alma-mesic/school-bell-system/desktop-app/SchoolBellSystem/4k-Abstract-Gradient-Wave-Digital-Art-Wallpaper.jpg

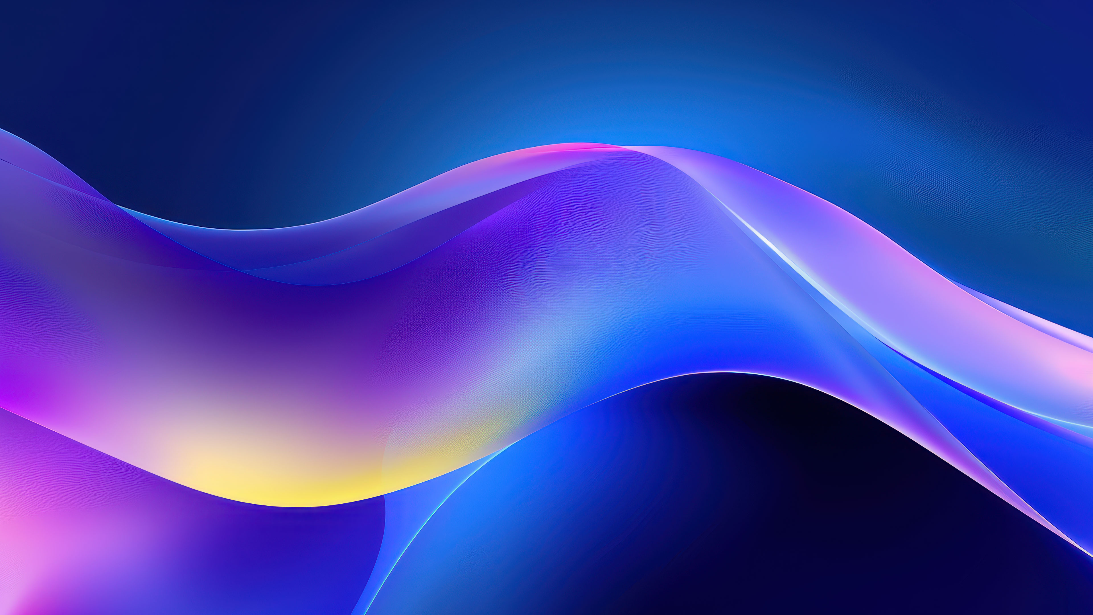
desktop-app/SchoolBellSystem/4k-Abstract-Gradient-Wave-Digital-Art-Wallpaper.jpg
