alma-mesic/school-bell-system/desktop-app/SchoolBellSystem/SchoolBellSystem/Resources/Untitled design1.png

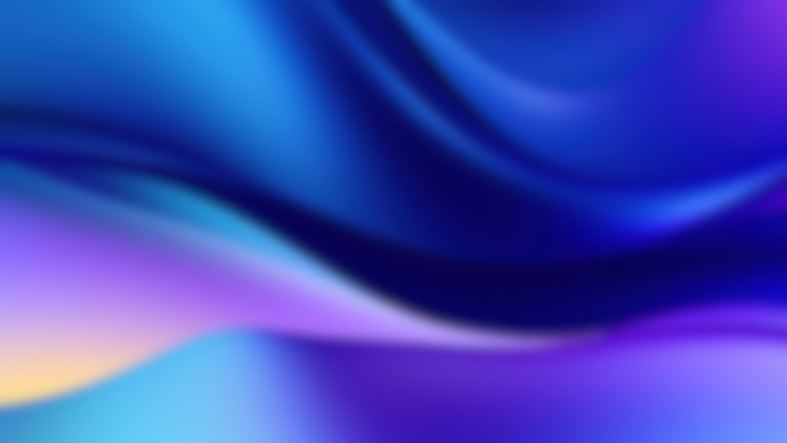
desktop-app/SchoolBellSystem/SchoolBellSystem/Resources/Untitled design1.png
