alma-mesic/school-bell-system/docs/tabela komponenti.docx

Naziv komponente | Izgled komponente | Kratak opis

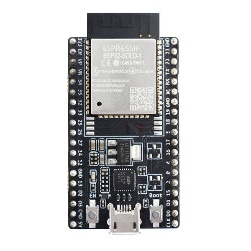
[picture p3: figure]
ESP32-DevKitC-S1 Espressif Systems | Mouser Hungary

- ESP32 mikrokontroler | | ESP32 mikrokontroler upravlja senzorima, prikazom i komunikacijom uređaja, omogućavajući automatsko prikupljanje i obradu podataka.

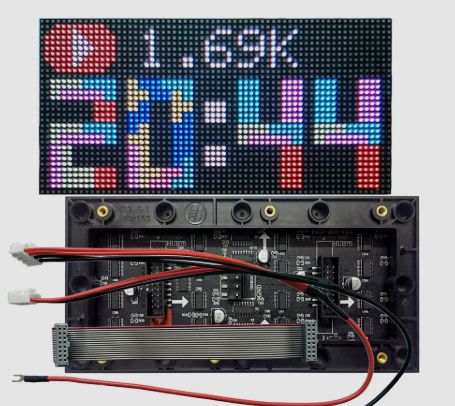
[picture p4: figure]

- LED Matrica HUB75 32x64 P4 (RGB) | | LED matrica HUB75 32x64 P4 (RGB) prikazuje slike, tekst i animacije u boji pomoću kontrolisanih RGB LED dioda, gdje P4 označava razmak između piksela od 4 mm.

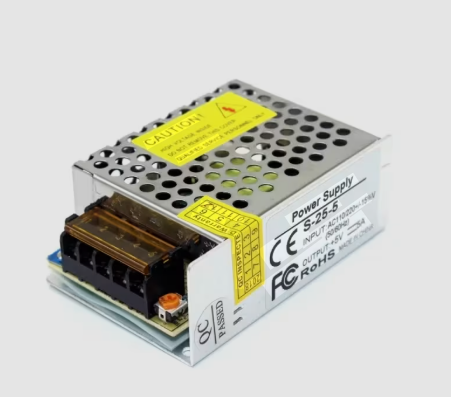
[picture p5: figure]

- Napojna jedinica (5V, 5A, 25W) | | Napojna jedinica (5V, 5A, 25W) služi za napajanje slova na ploči i daje dovoljan napon matrici.

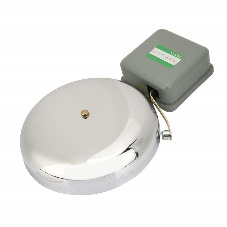
[picture p6: figure]
School Ring Time Bell 8 inch Stainless Steel Electric Bell Ring Factory Agencies School Home Use 220V 35W : Amazon.com.au: Home Improvement

- Školsko zvono | | Školsko zvono omogućava zvonjavu u predivđeno vrijeme i njime se operiše uz pomoć releja koji zatvara i otvara kontakt propuštajući signal.

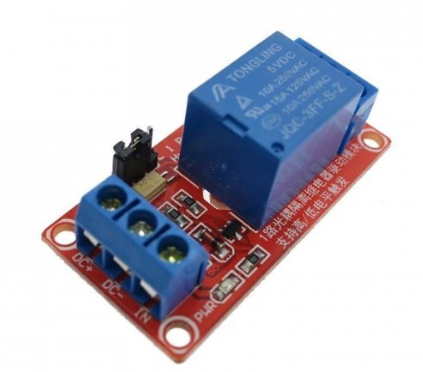
[picture p7: figure]

- Relej | | Relej modul omogućava ESP32 mikrokontroleru da upravlja fizičkim školskim zvonom uključivanjem i isključivanjem strujnog kola.

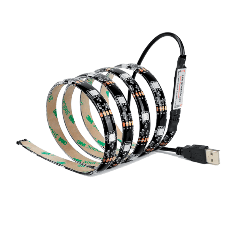
[picture p8: figure]
USB LED TRAKA 5050 5VDC 30PCS/M IP20 RGB 3m | ELMARK

- RGB LED traka | | RGB LED traka pruža osvjetljenje u više nijansi boja zbog prisustva crvenih, zelenih i plavih dijoda. Korisna je za ljepši vizuelni prikaz i radi estetike.

Tabela 1.1. najvažnije korištene komponente

Napomena:

U datoj tabeli su prikazane najvažnije komponente korištene za izradu ovog maturskog rada. Ukupni opis svih komponenata nalazi se u poglavlju 4. (Hardversko rješenje za School Bell System s LED reklamom).

Izrada ovog maturskog rada zasniva se na povezivanju nekoliko ključnih dijelova koji zajedno omogućavaju da cijeli sistem radi precizno i bez zastoja. Glavna komponenta je ESP32 mikrokontroler, koji možemo opisati kao mozak uređaja. Njegov zadatak je da prikuplja podatke, obrađuje ih i šalje naredbe ostalim dijelovima kako bi cijeli proces bio potpuno automatizovan. Za prikazivanje informacija, tačnog vremena i različitih animacija, korištena je LED matrica HUB75. Zahvaljujući gustom rasporedu RGB dioda, tekst i prikaz su jasni i lako čitljivi čak i sa veće udaljenosti.

Kako bi sve ove komponente funkcionisale stabilno, ugrađena je napojna jedinica od 5V. Ona je veoma bitna jer osigurava stalan napon, čime se izbjegava treperenje matrice ili problemi u radu mikrokontrolera kada je potrošnja energije najveća.

Poseban dio projekta čini sistem za upravljanje školskim zvonom. Budući da mikrokontroler radi na niskom naponu i ne može direktno pokretati jače električne uređaje, u sklop je ubačen relej. On služi kao elektronski prekidač koji, po signalu sa ESP32, zatvara strujni krug i aktivira zvono u tačno predviđeno vrijeme.

Na samom kraju, ugrađena je i RGB LED traka koja upotpunjuje vizuelni izgled uređaja. Ona pruža ambijentalno osvjetljenje, a zbog kombinacije osnovnih boja, omogućava prilagođavanje izgleda samog kućišta. Sve ove komponente zajedno čine jednu cjelinu koja uspješno povezuje funkciju digitalnog informativnog panela i sistema za automatsko aktiviranje školskog zvona.

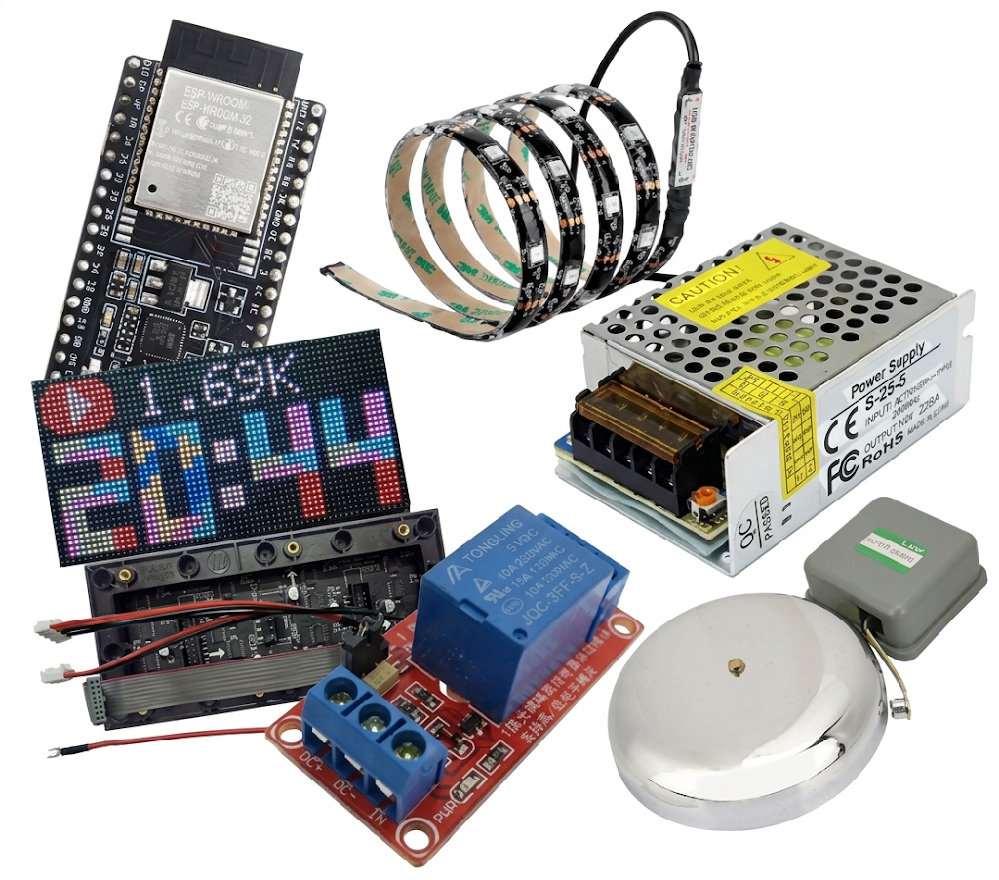
[picture p9: figure]

Slika 2.1. najvažnije korištene komponente
