alma-mesic/school-bell-system/docs/Maturski rad - urnek (1).docx

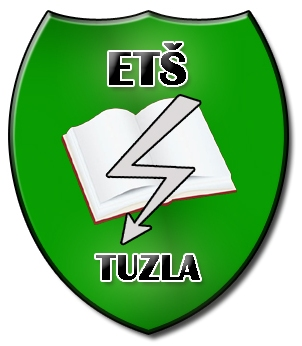
[picture p10: figure]
Description: Description: zelena2

JU MJEŠOVITA SREDNJA ELEKTROTEHNIČKA ŠKOLSKA GODINA

ŠKOLA TUZLA 2025./2026.

MATURSKI RAD

Predmet: Digitalna tehnika

Tema: School Bell System

MENTOR: UČENIK:

Zulfić Edin, dipl. ing. el.teh. Alma Mešić

Mandžukić Asmir, dipl. ing. el. teh Lamija Mujkić

TUZLA, maj, 2026.god.

# 1. Uvod

Četiri godine pohađamo ovu školu i dobro poznajemo njene hodnike, učionice i dnevni ritam nastave. Ipak, čak i uz toliko iskustva, određena obavještenja i rasporedi skraćene nastave često ostaju nepoznanica do posljednje minute. Često se dešava da učenici ili posjetioci škole ne znaju gdje se trebaju nalaziti, posebno u situacijama kada se u hodnicima istovremeno nalazi veliki broj ljudi. Tokom međusmjena, kada se približno pedeset učenika kreće hodnicima u isto vrijeme, lako može doći do konfuzije, a pravovremeno informisanje postaje gotovo nemoguće.

Problem je naročito vidljiv kod posjetilaca, gostujućih predavača ili novih učenika, koji nemaju iskustvo kretanja unutar škole. Oni se često suočavaju s nejasnim rasporedom i moraju se oslanjati na druge učenike ili nastavno osoblje kako bi saznali gdje trebaju biti. Slično važi i za situacije kada nastavnici moraju pratiti promjene rasporeda ili posebno obavještenja, kao što su promjene termina nastave, testiranja ili vanredna obavještenja. U takvim okolnostima ručno praćenje rasporeda i obavještenja može biti zamorno, nepraktično i sklono greškama.

Zbog ovih izazova, ideja projekta „School Bell System“ proizašla je iz stvarne potrebe da se upravljanje školskim rasporedom i obavještenjima pojednostavi i učini dostupnim u realnom vremenu. Sistem je zamišljen tako da učenicima, nastavnicima i posjetiocima pruži jednostavan, pregledan i pouzdan način praćenja svih relevantnih informacija. Ideja nije samo da se automatizuje zvono, već i da se omogući pravovremeno obavještavanje o događanjima unutar škole, uključujući raspored skraćene nastave, testove, posebne obavijesti i hitne situacije.

Primarna svrha sistema je stvoriti okruženje u kojem svi korisnici – bilo da su učenici, nastavnici ili posjetioci – imaju pristup ažurnim informacijama bez potrebe za dodatnim pitanjima, provjerama ili čekanjem. Time se ne samo smanjuje konfuzija i stres u hodnicima, već se i poboljšava efikasnost svakodnevnog školskog života. Učenici mogu planirati svoje vrijeme između časova, a nastavno osoblje može lakše organizovati aktivnosti i pratiti promjene u rasporedu.

Ovaj projekat takođe demonstrira kako primjena jednostavnih, ali praktičnih tehnologija može značajno unaprijediti svakodnevne procese u školskom okruženju. Ideja je da sistem bude intuitivan i jednostavan za korištenje, tako da njegova primjena ne zahtijeva dodatnu obuku niti tehničko predznanje korisnika. Cilj je omogućiti da informacije budu dostupne svima u realnom vremenu, a da pritom cijeli proces bude automatizovan i pouzdan.

Kombinacija ovih funkcionalnosti – automatsko zvono, prikaz obavještenja i upravljanje rasporedom – predstavlja kompletno rješenje za jednu od svakodnevnih, ali značajnih problema unutar škole. Uvođenjem ovog sistema, škola dobija način da na moderan i efikasan način informiše sve korisnike i smanji potrebu za manuelnom kontrolom. To omogućava bolju organizaciju i poboljšava ukupno iskustvo učenika i osoblja u školskom okruženju, čineći svakodnevne aktivnosti jasnijim i preglednijim.

# 2. Korištene komponente i tehnička osnova

Naziv komponente | Izgled komponente | Kratak opis

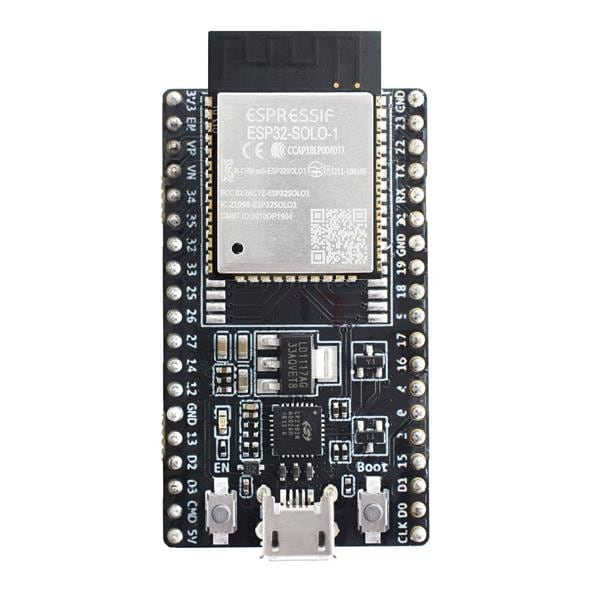
[picture p11: figure]
ESP32-DevKitC-S1 Espressif Systems | Mouser Hungary

- ESP32 mikrokontroler | | ESP32 mikrokontroler upravlja senzorima, prikazom i komunikacijom uređaja, omogućavajući automatsko prikupljanje i obradu podataka.


- LED Matrica HUB75 32x64 P4 (RGB) | | LED matrica HUB75 32x64 P4 (RGB) prikazuje slike, tekst i animacije u boji pomoću kontrolisanih RGB LED dioda, gdje P4 označava razmak između piksela od 4 mm.


- Napojna jedinica (5V, 5A, 25W) | | Napojna jedinica (5V, 5A, 25W) služi za napajanje slova na ploči i daje dovoljan napon matrici.

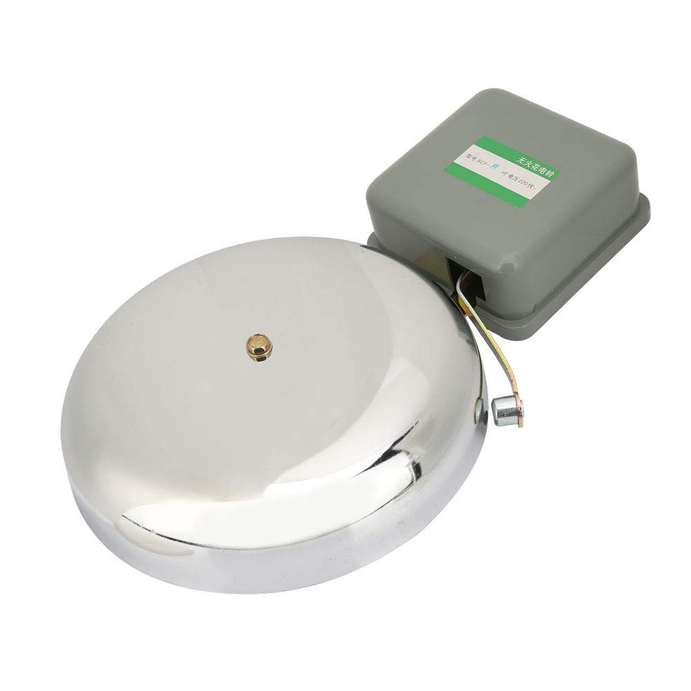
[picture p12: figure]
School Ring Time Bell 8 inch Stainless Steel Electric Bell Ring Factory Agencies School Home Use 220V 35W : Amazon.com.au: Home Improvement

- Školsko zvono | | Školsko zvono omogućava zvonjavu u predivđeno vrijeme i njime se operiše uz pomoć releja koji zatvara i otvara kontakt propuštajući signal.


- Relej | | Relej modul omogućava ESP32 mikrokontroleru da upravlja fizičkim školskim zvonom uključivanjem i isključivanjem strujnog kola.

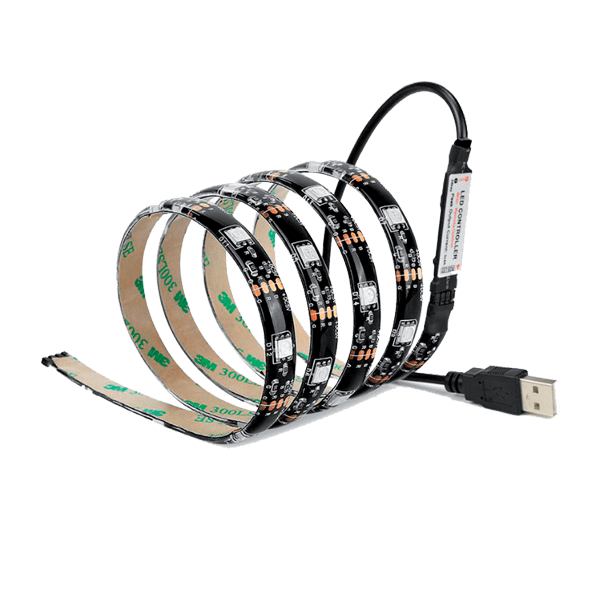
[picture p13: figure]
USB LED TRAKA 5050 5VDC 30PCS/M IP20 RGB 3m | ELMARK

- RGB LED traka | | RGB LED traka pruža osvjetljenje u više nijansi boja zbog prisustva crvenih, zelenih i plavih dijoda. Korisna je za ljepši vizuelni prikaz i radi estetike.

## 2.1. Esp32 mikrokontroler

ESP32-WROOM-32D je WiFi i Bluetooth dvojezgreni bežični komunikacijski modul koji je lansirala kompanija Espressif Systems. Ima dvojezgreni 32-bitni MCU koji integriše WiFi HT40 i Bluetooth/BLE 4.2 tehnologiju.

ESP32 čip (ESP wroom 32) integriše bogatstvo hardverskih perifernih uređaja, uključujući kapacitivne senzore dodira , Hall senzore , pojačala senzora sa niskim šumom, interfejse za SD kartice , Ethernet interfejse, brze SDIO/SPI, UART, I2S i I2C, itd.

ESP32 periferijski uređaji uključuju:

- 18 kanala analogno-digitalnog pretvarača (ADC)
- 3 SPI interfejsa
- 3 UART interfejsa
- 2 I2C interfejsa
- 16 PWM izlaznih kanala
- 2 digitalno-analogna pretvarača (DAC)
- 2 I2S interfejsa
- 10 kapacitivnih GPIO-a za očitavanje

Funkcije ADC-a (analogno-digitalnog pretvarača) i DAC-a (digitalno-analognog pretvarača) dodijeljene su određenim statičkim pinovima. Međutim, može se odlučiti koji su pinovi UART, I2C, SPI, PWM itd. - samo ih treba dodijeliti u kodu. To je moguće zahvaljujući funkciji multipleksiranja ESP32 čipa.

Iako svojstva pinova možemo definirati u softveru, postoje pinovi koji su dodijeljeni po zadanim postavkama kao što je prikazano na slici 2.1.1.

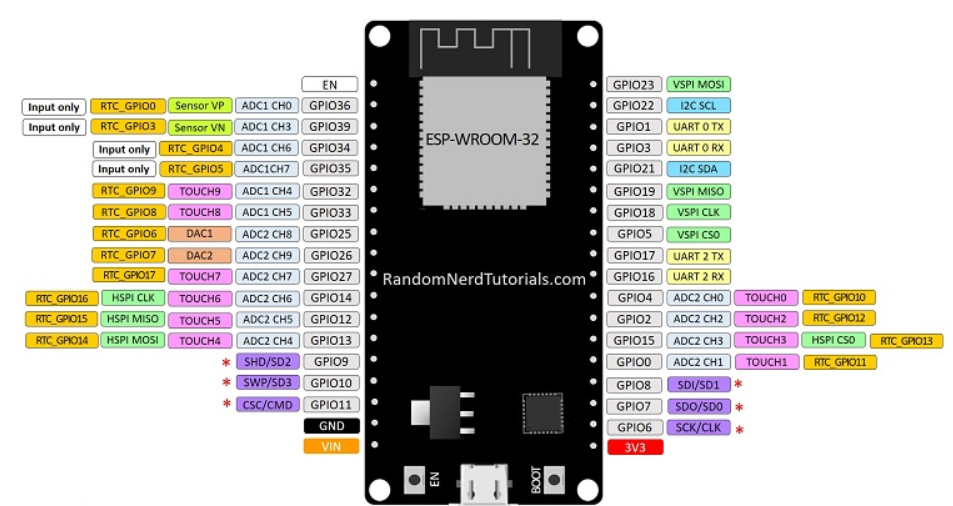
[picture p14: figure]

Slika 2.1.1.. ESP32 pinout

Ovi periferni uređaji i fleksibilna raspodjela pinova omogućavaju ESP32 mikrokontroleru da upravlja različitim komponentama i uređajima prema potrebama projekta.

Zahvaljujući kombinaciji visoke procesorske snage, energetske efikasnosti i ugrađenih komunikacijskih modula, ESP32 omogućava izradu kompleksnih i interaktivnih sistema koji mogu pratiti i reagovati na promjene u realnom vremenu, čime se značajno proširuju mogućnosti primjene u raznim pametnim i automatizovanim uređajima.

## 2.2. LED Matrica HUB75 32x64 P4 (RGB)

LED matrica HUB75 32x64 P4 (RGB) je panel sastavljen od 32x64 adresabilnih RGB LED dioda koje omogućavaju prikaz tekstova, slika i animacija u boji. Razmak između piksela od 4 mm (P4) pruža dobru preglednost na srednjim udaljenostima, dok istovremeno omogućava visoku gustinu prikaza.

Odlikuju je karakteristike od 2048 pojedinačne RGB LED diode, ekran u punom koloru, te podesiva svjetla. Dimenzija jedne matrice je 256cm x 128cm, a na ploči su dva HUB75 priključka, jedan za ulaz podataka kontrolera, jedan za izlaz i podrška za lanac. Ovaj tip matrice pruža online resurse i tutorijale za razvoj otvorenog koda, za upotrebu s Raspberry Pi, Arduinom i tako dalje.

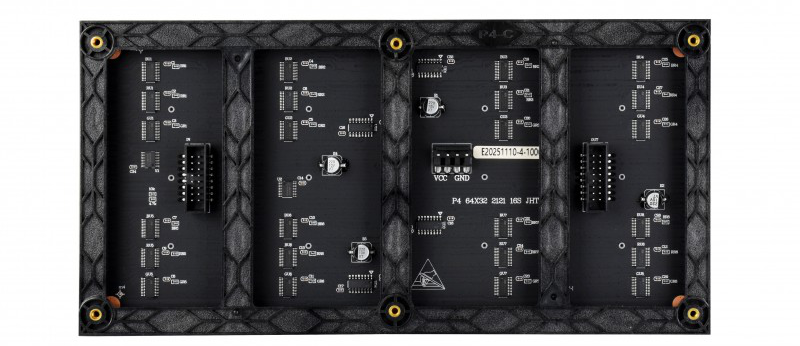
[picture p15: figure]
RGB Full-Color LED Matrix Panel, 4mm Pitch, 64×32 Pixels, Adjustable Brightness | RGB-Matrix-P4-64x32

Slika 2.2.1. pozadina LED 64x32 matrice

PIN | OPIS | | PIN | OPIS
VCC | Ulazno napajanje od 5V | | GND | Uzemljenje
R1 | Podaci višeg bita R | | R2 | Podaci nižeg bita R
G1 | Podaci višeg bita G | | G2 | Podaci nižeg bita G
B1 | Podaci višeg bita B | | B2 | Podaci nižeg bita B
A | Odabir A linije | | B | Odabir B linije
C | Odabir C linije | | D | Odabir D linije
E | Izbor E linije | | CLK | ulaz takta
LAT/STB | latch pin | | OE | output enable

Tabela 2.2.1. raspored pinova LED matrice

Tehnički detalji

- Dimenzije: 255 mm x 127 mm x 15 mm / 10,0” x 5,0” x 0,6”
- Težina panela sa IDC kablovima i kablovima za napajanje: 252,8 g
- Kompatibilan s M3 vijcima za montažu
- Regulisani ulaz napajanja od 5V, ~4A maks. (sve LED diode uključene)
- Brzina skeniranja 1/16
- Unutrašnji ekran, vidljivost od 160 stepeni
- Ekrani se mogu lančano/serijski povezivati - povezivanjem jednog izlaza sa sljedećim ulazom

## 2.3. Napojna jedinica

Napojna jedinica je ključna komponenta svakog elektronskog sistema, jer obezbjeđuje stabilan i pouzdan izvor energije za sve uređaje i module. Njena osnovna funkcija je da pretvara električnu energiju iz izvora napajanja, poput mreže ili baterije, u napone i struje prilagođene potrebama povezane elektronike.

Osim toga, napojna jedinica štiti uređaje od prenapona i kratkog spoja u napajanju, čime se smanjuje rizik od oštećenja i prekida u radu sistema.

Princip rada napojne jedinice zasniva se na pretvaranju i regulaciji električne energije. Ulazna struja se kroz transformator, ispravljač i filtere pretvara u jednosmernu struju odgovarajuće snage, dok regulator napona održava konstantan izlazni napon bez obzira na promjene u opterećenju ili ulaznoj struji.

Za naš projekat koristimo napojnu jedinicu od 5 V i 5 A, koja je dovoljna da napaja LED matricu i RGB trake na slovima. Ovaj izbor omogućava sigurno i stabilno napajanje svih LED dioda, bez fluktuacija napona ili prenapona, čime se osigurava pravilno i ujednačeno osvjetljenje i pouzdan rad sistema.

# 3. Korištene tehnologije

U izradi ovog maturskog rada korišten je niz tehnologija i razvojnih okruženja koja su omogućila realizaciju funkcionalnosti sistema. Ključnu ulogu u razvoju imali su programski jezici C++ i C#, koji su korišteni za implementaciju logike mikrokontrolerskog sistema i desktop aplikacije. Pored njih, značajnu ulogu imao je i JavaScript, dok su za izradu korisničkog interfejsa web aplikacije korišteni označivački (markup) jezici HTML i CSS. Za praćenje promjena u kodu i međusobnu koordinaciju razvoja korišten je GitHub, pri čemu su izmjene slane i preuzimane putem PowerShell-a, omogućavajući efikasnu saradnju između članova tima.

Za razvoj i testiranje softvera korišteno je više razvojnih platformi. Microsoft Visual Studio korišten je za razvoj desktop aplikacije u .NET okruženju koristeći C#, dok je Visual Studio Code pružao efikasno okruženje za rad sa HTML, CSS i JavaScript tehnologijama. Programiranje i komunikacija sa ESP32 mikrokontrolerom realizovana je pomoću Arduino IDE, koja omogućava jednostavno pisanje, kompajliranje i učitavanje programa na mikrokontroler.

U nastavku slijedi detaljnije objašnjenje korištenih platformi i alata.

## 3.1. Microsoft Visual Studio

Microsoft Visual Studio je integrisano razvojno okruženje (IDE) koga je razvio Microsoft. Koristi se za razvoj računarskih programa za Windows, web-stranice, aplikacije i druge usluge. Visual Studio sadrži uređivač izvornog kôda koji podržava IntelliSense (komponenta koja predlaže ostatak kôda) kao i refaktoriranje kôda. Integrirani program za otklanjanje grešaka (debugger) radi na nivou izvornog i mašinskog koda. Program također sadrži alate poput dizajnera oblika koji se koristi za pravljenje aplikacija s grafičkom korisničkim interfejsom, web-dizajnera, dizajnera klasa i dizajnera shema baza podataka.

Visual Studio podržava različite programske jezike i dozvoljava uređivaču kôda i debuggeru da podržava (u različitoj mjeri) gotovo bilo koji programski jezik, pod uslovom da usluga za taj jezik postoji. Ugrađeni jezici su C, C++ i C++/CLI (preko Visual C++), VB.NET (preko Visual Basic .NET)-a, C# (preko Visual C#) i F# (počevši od programa Visual Studio 2010).

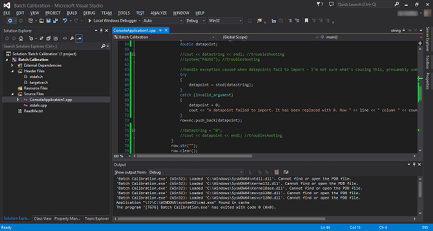
[picture p16: figure]
Snimak ekrana programa Visual Studio 2013. Uređuje se izvorni kôd u programskom jeziku C++
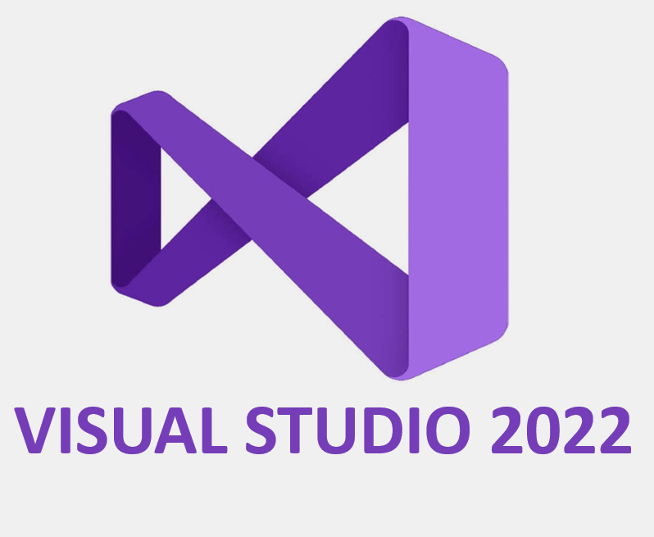
[picture p17: figure]
Visualstudio 2022 Community(J) : Microsoft : Free Download, Borrow, and Streaming : Internet Archive

Slika 3.1.1. izgled Microsoft Visual Studio okruženja

.NET je platforma otvorenog koda za izradu desktop, web i mobilnih aplikacija koje se mogu izvorno pokretati na bilo kojem operativnom sistemu. .NET sistem uključuje alate, biblioteke i jezike koji podržavaju moderan, skalabilan i visoko performansni razvoj softvera. Aktivna zajednica programera održava i podržava .NET platformu u kojoj je i naša prvobitna aplikacija izvedena.

## 3.2. Visual Studio Code

Visual Studio Code ( prev . Visual Studio Code , skraćeno VS Code ) je uređivač izvornog koda koji je razvio Microsoft za Windows , Linux i Mac OS . Podržava otklanjanje grešaka, ugrađenu Git kontrolu i GitHub, isticanje sintakse, inteligentno dovršavanje koda, isječke i refaktorisanje koda. Visoko je prilagodljiv, omogućavajući korisnicima da mijenjaju temu, prečice na tastaturi, postavke i instaliraju dodatke za dodatne funkcionalnosti. Izvorni kod je besplatan i otvorenog koda i objavljen je pod permisivnom MIT licencom. Kompajlirani binarni fajlovi su besplatni i besplatni za ličnu ili komercijalnu upotrebu.

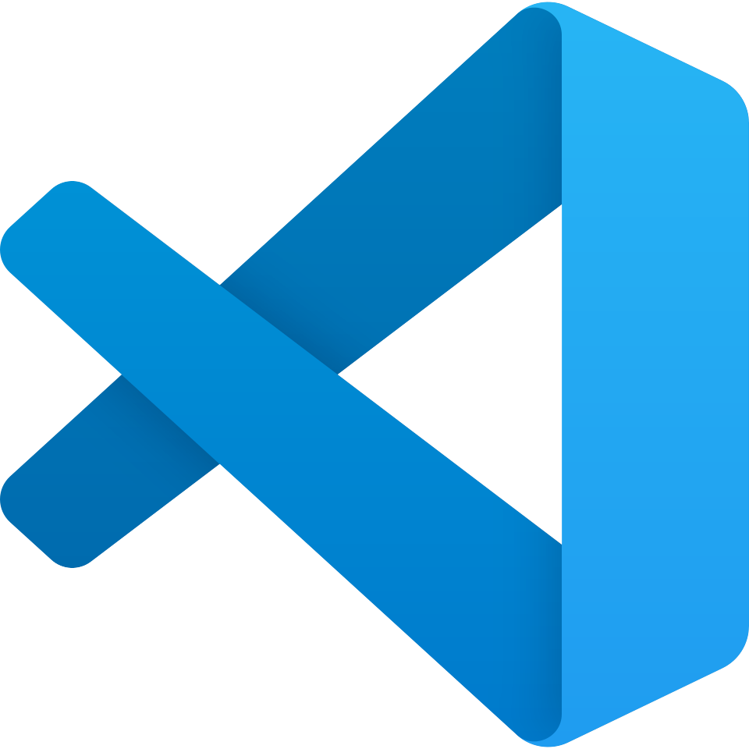
[picture p18: figure]
nedefinirano
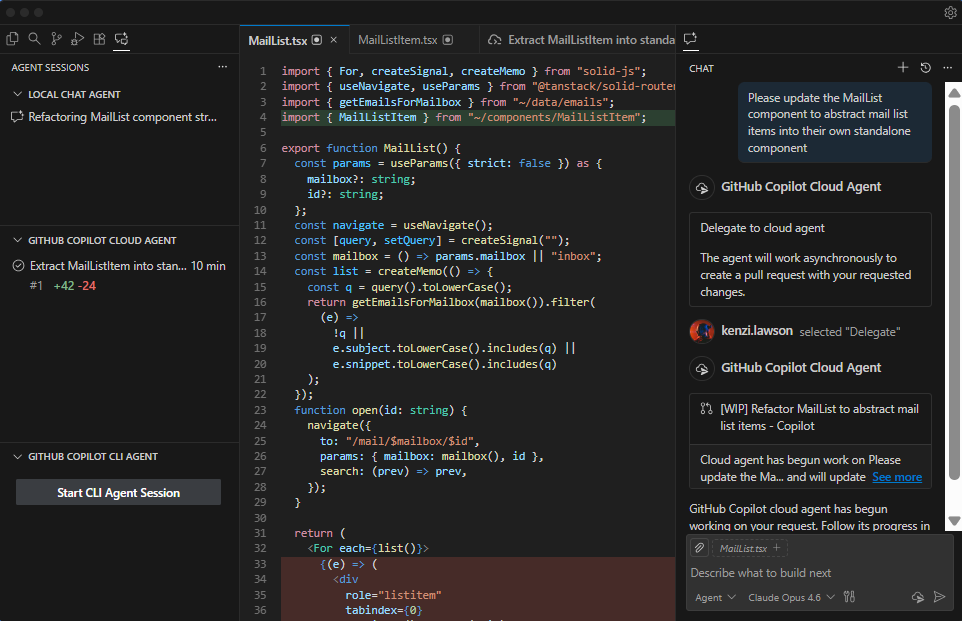
[picture p19: figure]

Slika 3.2.1. izgled Visual Studio Code okruženja

Visual Studio Code pruža niz funkcija koje olakšavaju efikasan rad s kodom. Jedna od ključnih je source control, koja omogućava praćenje promjena i upravljanje projektima putem Git-a i drugih sistema verzioniranja. Okruženje podržava brojne programske jezike poput Python-a, C++, JavaScript-a i nudi osnovne funkcije poput isticanja sintakse, uparivanja zagrada i preklapanja dijelova koda.

IntelliSense pomaže programerima automatskim dovršavanjem koda, prijedlozima za varijable i funkcije te otkrivanjem grešaka. Pored toga, VS Code nudi refaktorisanje koda, kodne isječke, integrisani Git i mogućnost prilagođavanja korisničkog sučelja instalacijom ekstenzija, promjenom tema i korištenjem prečica na tastaturi.

## 3.3. Arduino IDE

Za programiranje Arduina ili bilo kog drugog mikrokontrolera potreban nam je softver u koji možemo pisati i prenositi kod. Ovaj zadatak obavlja Arduino IDE. Zbog varijacija u vrsti operativnog sistema instaliranog u Windowsu, Mac OS X-u i Linuxu, postojala je potreba za razvojem platforme koja bi dobro funkcionirala za svaki operativni sistem. IDE, što se odnosi na integrirano razvojno okruženje (Integrated Development Environment), je softver koji se koristi za pisanje kodova koji kontroliraju Arduino u programskim jezicima poput C i C++.

Arduino IDE je vrlo jednostavan i ta jednostavnost je vjerovatno jedan od glavnih razloga zašto je Arduino postao toliko popularan. Tokom godina, mnoge korisne funkcije su dodane u Arduino IDE i sada možemo upravljati bibliotekama i pločama trećih strana iz IDE-a, a da i dalje zadržimo jednostavnost programiranja ploče. Glavni prozor Arduino IDE-a prikazan je ispod.

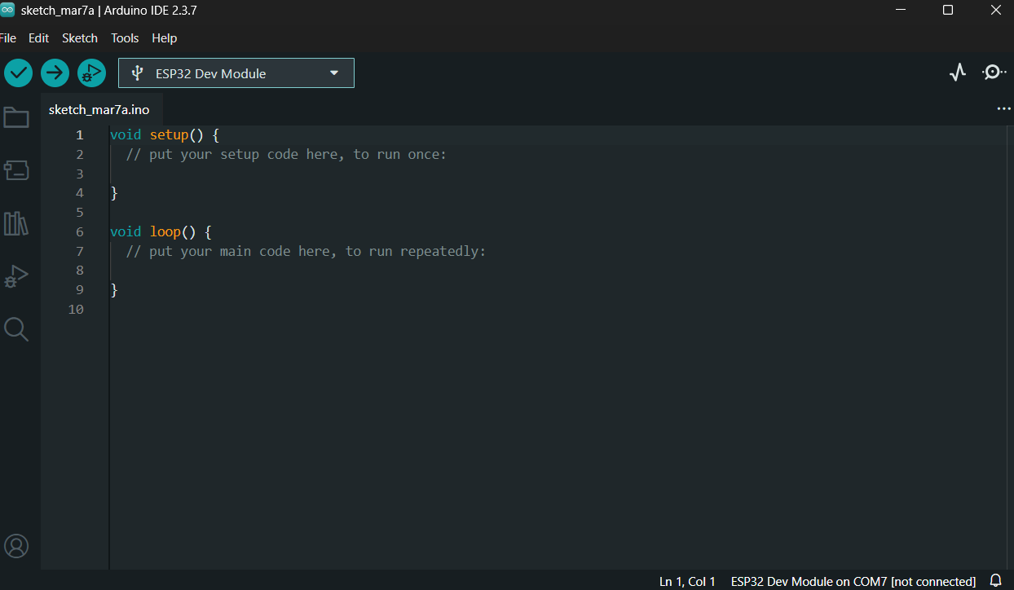
[picture p20: figure]

Slika 3.3.1. izgled Arduino IDE okruženja

Pored osnovne funkcionalnosti pisanja i učitavanja koda na mikrokontroler, Arduino IDE nudi niz korisnih opcija i alata koji olakšavaju razvoj i testiranje. Najvažnije značajke Arduino IDE-a uključuju:

- Serial Monitor
- Libraries (biblioteke)
- Boards (ploče)
- Primjeri koda
- Jednostavan interfejs

# 4. Hardversko rješenje za School Bell System s LED reklamom

## 4.1. Hardverska arhitektura i povezivanje

Povezivanje ESP32 kontrolera sa LED matricom vrši se putem HUB75 interfejsa. Budući da panel nema sopstvenu memoriju niti procesor za obradu slike, ESP32 preuzima ulogu glavnog upravljača koji konstantno, velikom brzinom, šalje podatke o svakom pikselu.

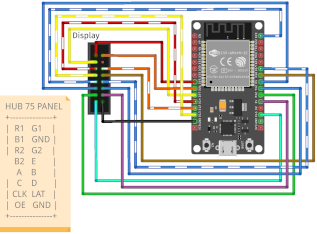
[picture p21: figure]

Slika 4.1.1. spoj matrice i esp32 mikrokontrolera

Pojašnjenje uloga pojedinih pinova:

- Linije za podatke o boji (R1, G1, B1 i R2, G2, B2): Ovi pinovi prenose informacije o crvenoj, zelenoj i plavoj boji. Specifičnost HUB75 panela je što je podijeljen na dvije sekcije. Prva grupa (1) šalje podatke za gornju polovinu ekrana, dok druga grupa (2) istovremeno šalje podatke za donju polovinu, što omogućava brže osvježavanje slike.
- Adresne linije (A, B, C, D): Ovi pinovi služe za odabir konkretnog reda koji se u tom trenutku iscrtava. Oni rade po principu binarnog adresiranja (npr. kombinacija signala na ovim pinovima govori panelu: "sada pali 5. red"). Broj ovih linija određuje koliko redova panel može imati (npr. do linije D za panele sa 32 reda).
- CLK (Clock - Takt): Ovaj pin služi kao "metronom" sistema. Svaki put kada se na CLK pinu desi impuls, panel zna da treba očitati novi bit podatka sa linija za boju. Bez ovog signala, prenos podataka ne bi bio sinhronizovan.
- LAT / STB (Latch - Zaključavanje): Nakon što ESP32 pošalje podatke za cijeli jedan red, šalje signal na LAT pin. To govori panelu da su podaci stigli i da ih "preslika" na same LED diode.
- OE (Output Enable - Aktiviranje izlaza): Ovaj pin kontroliše da li su diode uopšte upaljene. Osim što služi za sprečavanje "ghosting" efekta (razmrljane slike) tokom smjene redova, on se koristi i za softversku kontrolu svjetline ekrana putem PWM metode.

Takođe, jako je važno napomenuti da je potrebno koristiti zajedničko uzemljenje (GND) između napajanja i ESP32 ploče kako bi ovi signali bili stabilni i bez smetnji jer bez te zajedničke mase, panel može početi da izbacuje nasumične boje, treperi ili uopšte ne reaguje, jer ne prepoznaje pravilno naponske nivoe koje mu ESP32 šalje.

Kako bismo eliminisali probleme sa labavim kontaktima i smetnjama koje uzrokuju klasični kablovi, u finalnoj fazi smo izbjegli korištenje pojedinačnih kratkospojnika i konektora za svaki pin. Umjesto toga, projektovali smo namjenski shield koji direktno povezuje ESP32 sa panelom, čime smo kroz fiksne vodove štampane ploče osigurali maksimalnu stabilnost signala, urednost sistema i pouzdan rad bez rizika od pogrešnog spajanja.

## 4.2. Izrada shielda za ESP32

Dizajn ploče je realizovan u programu Autodesk Eagle. Ovaj softver nam je omogućio precizno planiranje a detaljnije o program u nastavku…

### 4.2.1. Eagle

Autodesk Eagle (skraćeno od Easily Applicable Graphical Layout Editor) je softver za automatizaciju elektronskog dizajna (EDA) koji omogućava inženjerima i projektantima elektronike da povežu sheme i dizajniraju štampane ploče (PCB). Podržava napredne funkcije kao što su automatsko rutiranje vodova, provjera pravila dizajna (DRC) i usklađivanje električnih pravila (ERC). Program je visoko integrisan, omogućavajući korisnicima besprijekoran prelaz iz faze crtanja električne sheme u fazu fizičkog rasporeda komponenti na ploči.

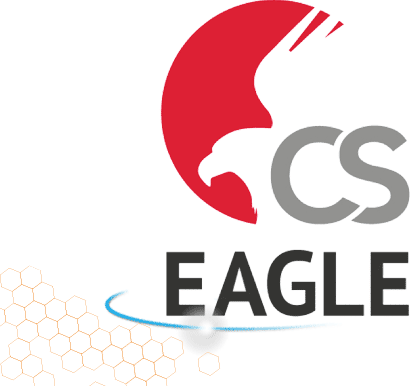
[picture p22: figure]

Slika 4.2.1. Izgled Autodesk Eagle okruženja

Autodesk Eagle pruža niz alata koji olakšavaju preciznu izradu hardverskih rješenja. Jedna od ključnih komponenti je Schematic Editor, koji se koristi za definisanje logičkih veza između elektronskih komponenti. Okruženje nudi bogate biblioteke simbola za hiljade komponenti, uključujući mikrokontrolere poput ESP32, različite senzore i konektore poput onih za HUB75 panel.

Layout Editor omogućava programerima i hardverašima fizičko dizajniranje ploče, određivanje debljine bakarnih vodova i postavljanje slojeva ploče. Eagle pomaže korisnicima kroz inteligentno rutiranje, vizualizaciju u 3D prikazu i generisanje fajlova potrebnih za industrijsku ili kućnu proizvodnju ploča. Pored toga, nudi mogućnost prilagođavanja korisničkog sučelja, rad sa skriptama i automatizaciju ponavljajućih zadataka kroz User Language Programs (ULP).

### 4.2.2. Fotopostupak izrade shielda

Nakon digitalnog dizajna, prešlo se na fizičku izradu ploče koristeći precizni fotopostupak.

Koraci izrade:

1. Priprema filma: Dizajn vodova smo isprintali na prozirnu foliju laserskim printerom, pazeći da crna boja bude potpuno neprozirna kako bi blokirala UV zrake.
2. Osvjetljavanje (Ekspozicija): Pločicu presvučenu foto-osjetljivim lakom smo prekrili folijom i izložili UV svjetlosti. Svjetlost je "stvrdnula" lak svuda osim na mjestima gdje su nacrtani naši vodovi.
3. Razvijanje: Pločica se potapa u razvijač (rastvor natrijum-hidroksida) koji uklanja neosvijetljeni lak. Nakon ovog koraka, na bakru ostaje jasno vidljiva slika planiranih vodova.
4. Jetkanje (Nagrizanje kiselinom): Ovo je ključni dio procesa. Pločica se stavlja u rastvor kiseline (npr. mješavina hlorovodične kiseline i hidrogen-peroksida ili fero-hlorid). Kiselina hemijskom reakcijom uklanja sav bakar koji nije zaštićen lakom, ostavljajući samo naše dizajnirane putanje.
5. Finalizacija: Preostali zaštitni lak se skida alkoholom ili acetonom, nakon čega se vrši precizno bušenje rupa za pinove i lemljenje komponenti.

Ovim postupkom smo dobili profesionalan i pouzdan hardverski modul koji se jednostavno postavi na mikrokontroler, čime je projekat postao robustan i spreman za dugotrajan rad.

Slika 4.2.2.1

## 4.3. Ploča

# 5. Softversko rješenje za School Bell System s LED reklamom

Softversko rješenje sastoji se iz dvije aplikacije kreirane na dvije različite platforme u dva različita okruženja. Za njihovu izradu korišteni su označeni (markup) jezici, poput HTML-a, CSS-a i JavaScript-a, kao i programski jezik C#, te programski jezik C++. Također, za izradu aplikacija korištena su dva editora: Microsoft Visual Studio 2022 (Windows aplikacija) i Visual Studio Code (Web-aplikacija). Razlika između dvije aplikacije jeste u povezivanju s ESP32 mikrokontrolerom i samim slanjem podataka na isti. Njegov rad definisan je kroz .ino fajl programiran unutar Arduino IDE okruženja.

## 5.1. Windows .NET aplikacija

Prva aplikacija izrađena je u .NET okruženju, odnosno u programu Microsoft Visual Studio 2022. Prvobitna svrha ove aplikacije bila je da predstavlja glavno softversko rješenje ovog maturskog rada. Međutim, tokom razvoja pojavio se problem pri prijenosu podataka.

Naime, kako bi komunikacija između mikrokontrolera ESP32 i LED matrice bila moguća, bio je potreban fizički kontakt, odnosno kablovska veza koja bi omogućila razmjenu podataka. To je dovodilo do dodatnog problema: svaki put kada bi se novi podaci trebali poslati na matricu za ispis (npr. obavještenja ili raspored dežurnih profesora), bilo je potrebno skinuti matricu sa ploče, povezati je s laptopom i ponovo učitati kod.

Takav proces pokazao se nepraktičnim i neefikasnim za svakodnevnu upotrebu sistema. Zbog toga je ova aplikacija proglašena neadekvatnim rješenjem i ostavljena je kao rezervna opcija u slučaju da web-aplikacija ima poteškoće pri povezivanju. Može se reći da predstavlja „manualni“ pristup upravljanju sistemom.

Iako nije korištena kao primarno rješenje, ova aplikacija bila je prvi razvijeni softverski dio projekta te je, kao takva, važna za razumijevanje procesa razvoja cijelog sistema.

### Dizajn aplikacije

Dizajn aplikacije sastoji se od dvije forme.

Prva forma koja se učitava pri pokretanju aplikacije zapravo predstavlja sekundarnu formu ovog projekta i služi kao log-in forma. Njen izgled prikazan je na slici 5.1.1.

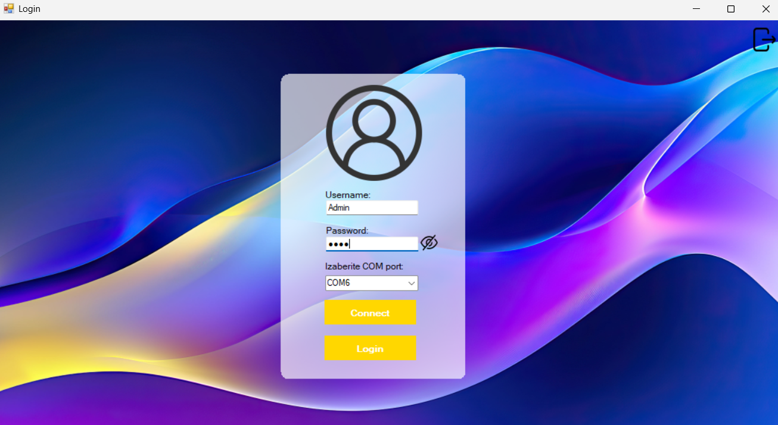
[picture p23: figure]

Slika 5.1.1. prikaz Log-in forme

Njena osnovna svrha je da osigura pristup sistemu tako što je u prva dva polja potrebno unijeti validne korisničke podatke kako bi se omogućio prelazak na primarnu formu aplikacije. Opcija odabira COM porta uvedena je zbog potrebe za povezivanjem mikrokontrolera ESP32 sa računarom prilikom učitavanja novih podataka. Bez ove opcije bilo bi potrebno definisati statički port direktno u kodu, što bi moglo uzrokovati probleme prilikom promjene računara ili komunikacijskog porta.

Pritiskom na dugme „Login“ vrši se provjera unesenih podataka, nakon čega se prikazuje odgovarajuća poruka u zavisnosti od njihove validnosti. Ukoliko su uneseni podaci ispravni, aplikacija se automatski povezuje sa mikrokontrolerom, a zatim se u MessageBox prozoru prikazuje potvrda o uspješnom povezivanju. Nakon toga korisnik se preusmjerava na početnu (Home) stranicu aplikacije prikazanu na slici 5.1.2.

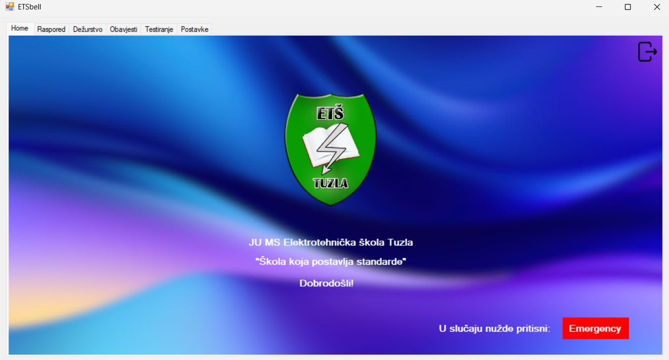
[picture p24: figure]

Slika 5.1.2. prikaz glavne forme

Na glavnoj formi nalazi se kontrola TabControl, koja omogućava kreiranje više tabova unutar jedne forme i korištenje istog .cs fajla za sve tabove. Ova kontrola izabrana je zbog praktičnosti i lakše navigacije korisnika između stranica.

Finalna verzija dizajna aplikacije sastoji se od šest tabova: Home, Raspored, Dežurstvo, Obavijesti, Testiranje i Postavke. Svaki tab izvršava odgovarajuće zadatke za koje je programiran. U nastavku slijedi detaljno objašnjenje:

- Home – predstavlja početnu stranicu. Na njoj je prikazan grb elektrotehničke škole s nazivom ispod i poznatim sloganom. U donjem desnom uglu nalazi se dugme za hitne slučajeve, namjerno postavljeno radi preglednosti i brzog pristupa. Ova stranica služi kao uvod u sistem i nema kompleksnu funkcionalnost.
- Raspored – sadrži dvije DataGridView kontrole za redovnu i skraćenu nastavu. Kontrole prikazuju tabelu sa 3 kolone (broj časa, početak i kraj) i 13 redova s podacima. Također sadrže radio dugmad za izbor redovnog ili skraćenog rasporeda te dugme „Pošalji na ESP“ koje šalje podatke na mikrokontroler.
- Dežurstvo – [ovdje je potrebno dodati opis funkcionalnosti ovog taba].
- Obavijesti – služe za slanje obavještenja na LED matricu. Sadrže dva DateTimePicker kontrola (za datum i vrijeme obavještenja) i tekstbox za unos naziva obavještenja. Tekstbox nema ograničenje broja karaktera, što omogućava unos više podataka u jednoj obavijesti (npr. raspored takmičara, osvojena mjesta ili lokacija kabineta). Obavijesti se prikazuju u ListBoxu, a dugmići „Dodaj“ i „Obriši“ omogućavaju upravljanje stavkama. Podaci se šalju na ESP klikom na odgovarajuće dugme, a nakon izvršenja obavijest se briše iz liste.
- Testiranje – koristi dvije dugmeta za početak i kraj zvona. Njegova svrha je testiranje ispravnosti rada zvona.
- Postavke – sadrži dva panela. Prvi panel omogućava promjenu podataka o adminu (ime, trenutna i nova šifra), a drugi panel služi za podešavanje Wi-Fi mreže (naziv i šifra). Podaci se spremaju klikom na dugmad „Sačuvaj“ ili „Novi podaci za login“, a pogrešni unosi prikazuju odgovarajuće poruke kroz MessageBox. Dodatno, unutar taba Postavke nalazi se dugme za čišćenje EEPROM-a, koje briše sve podatke na mikrokontroleru i postavlja prikaz na „Nema časa“.

### Funkcionalnost aplikacije

## 5.2. Web aplikacija

### Dizajn aplikacije

### Funkcionalnost aplikacije

## 5.3. .ino rješenje

# 6. Zaključak

7. Literatura

[1] https://randomnerdtutorials.com/esp32-pinout-reference-gpios/

[2] https://www.dfrobot.com/product-1559.html

[3] https://www.waveshare.com/

[4] https://www.adafruit.com/

[5] https://en.wikipedia.org/

[6] https://www.webopedia.com/

[7] https://code.visualstudio.com/

[8] https://www.geeksforgeeks.org/

[9]

[10]

[11]

[12]

[13]

[14]

[15]

Mišljenje mentora o radu: ____________________________________________________________________________________________________________________________________________________________________________________________________________________________________________________________________________________________________________________________________________________________________________________________________________________________________________________________________________________________________________________________________________________________________________________________________________________________________________________________________________________________________________________________________________________________________________________________________________________________________________________________________________________________________________________________________

Predložena ocjena: ___________________ ( __ )

Ispitivač:_____________________________

Članovi komisije:

1.___________________________________

2.___________________________________

Izdvojeno mišljenje:

Datum odbrane: ___. ___. _______.
