alma-mesic/school-bell-system/convert_app/Raspored dežurstva nastavnika od 06.04. do 10.04.2026.godine_ab4c01f0-7abc-49bd-96a5-f338d3f3a6a6.pdf

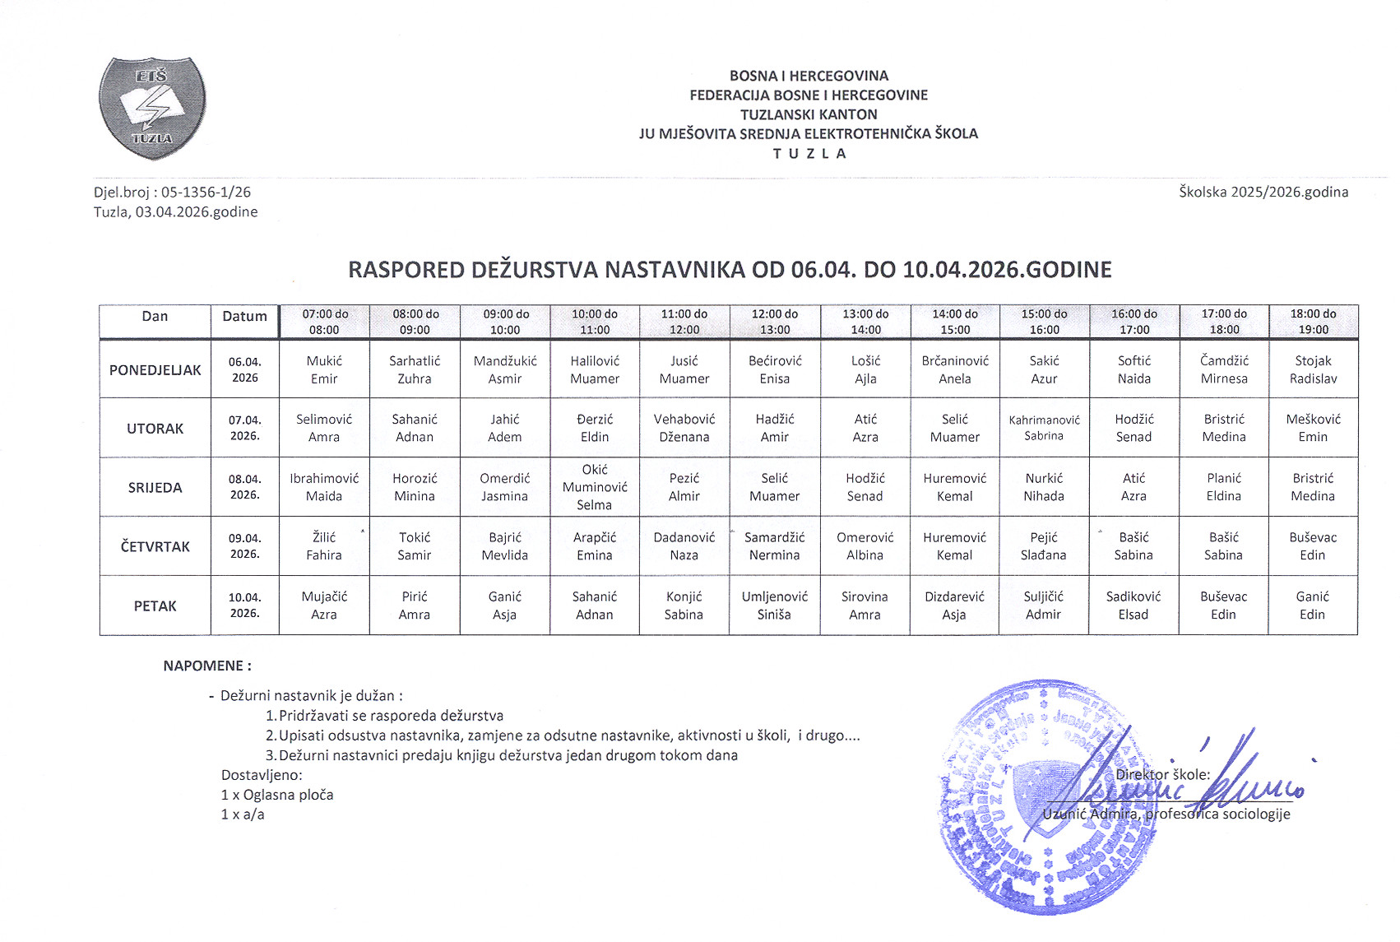
[picture p25: page 1]
