alma-mesic/school-bell-system/desktop-app/SchoolBellSystem/ets_grb.png

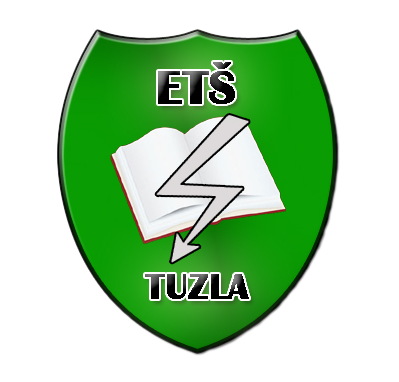
desktop-app/SchoolBellSystem/ets_grb.png
