alma-mesic/school-bell-system/docs/slike/0-02-05-070d012117d5129bbcc7c5ec8d613091a239f63e94dd69641e41625537111bdd_980ea1becd06d462.jpg

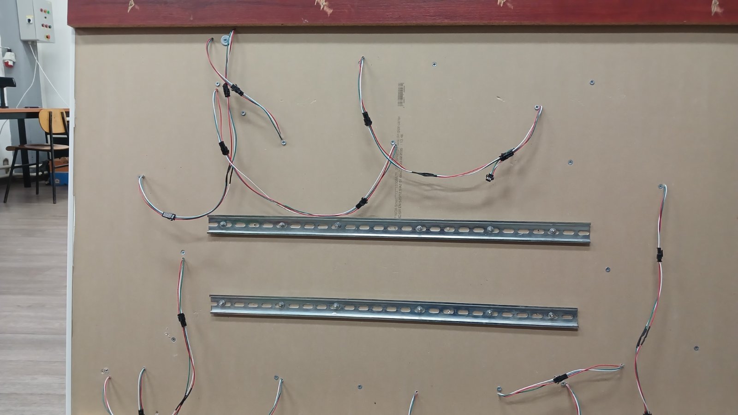
docs/slike/0-02-05-070d012117d5129bbcc7c5ec8d613091a239f63e94dd69641e41625537111bdd_980ea1becd06d462.jpg
