alma-mesic/school-bell-system/docs/slike/0-02-05-2846aa148b6b25d56c5fa1617f063af866d4cdd2f5a2c9c0d851def7b9c84b43_d1bc76faeaea43e7.jpg

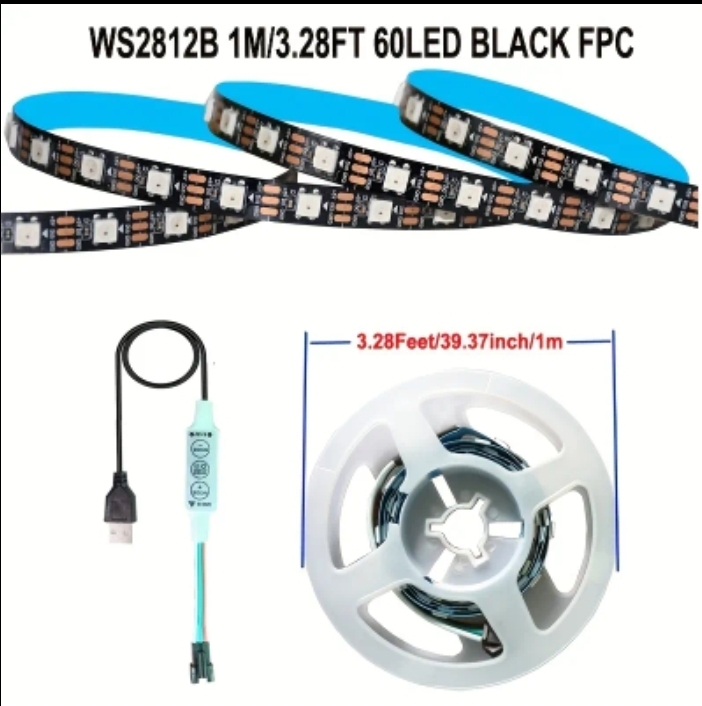
docs/slike/0-02-05-2846aa148b6b25d56c5fa1617f063af866d4cdd2f5a2c9c0d851def7b9c84b43_d1bc76faeaea43e7.jpg
