alma-mesic/school-bell-system/docs/slike/0-02-05-817695364f424f0f11785a3a3c420c07fe26433e1aab2a58d577dc8072370dc2_80c6a2fa607ca79b.jpg

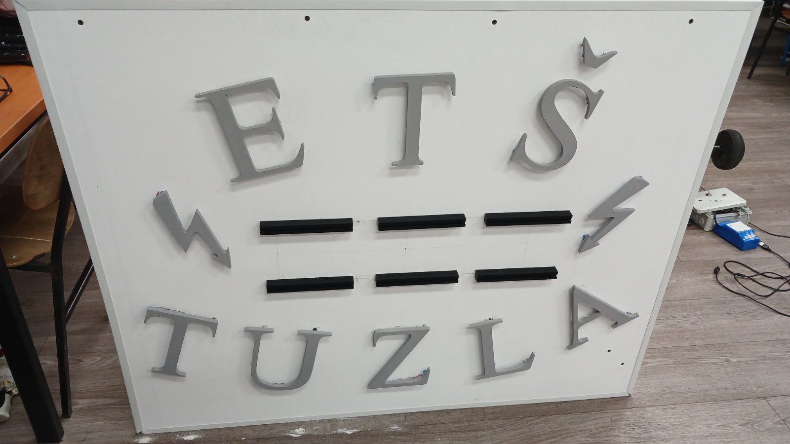
docs/slike/0-02-05-817695364f424f0f11785a3a3c420c07fe26433e1aab2a58d577dc8072370dc2_80c6a2fa607ca79b.jpg
