alma-mesic/school-bell-system/docs/slike/0-02-05-ad29dce59cee625c4b72e755eb6426464af060989c28530f1aa00bad6c959e9d_78ac01da42d2a561.jpg

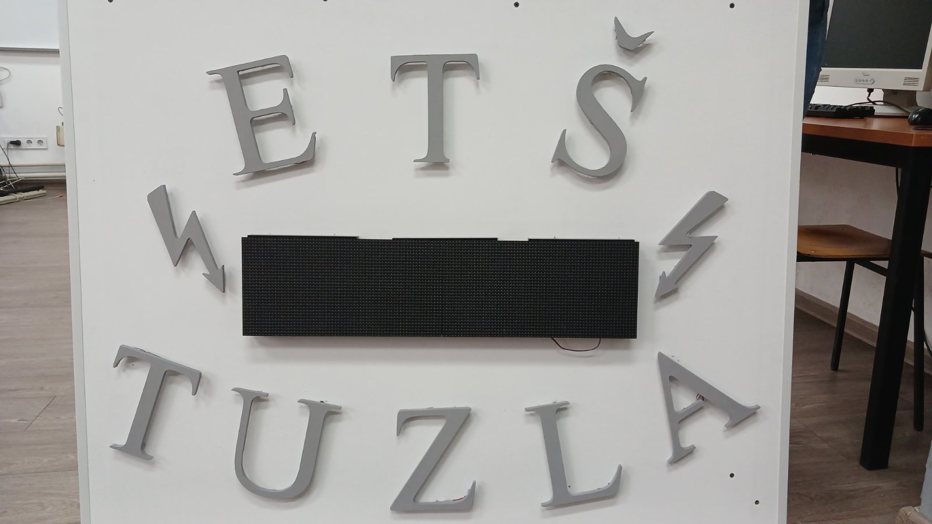
docs/slike/0-02-05-ad29dce59cee625c4b72e755eb6426464af060989c28530f1aa00bad6c959e9d_78ac01da42d2a561.jpg
