alma-mesic/school-bell-system/docs/slike/gotovo1.jpg

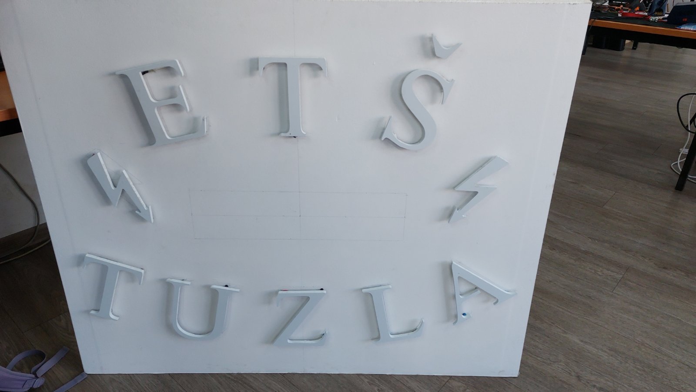
docs/slike/gotovo1.jpg
