alma-mesic/school-bell-system/docs/slike/gotovo.jpg

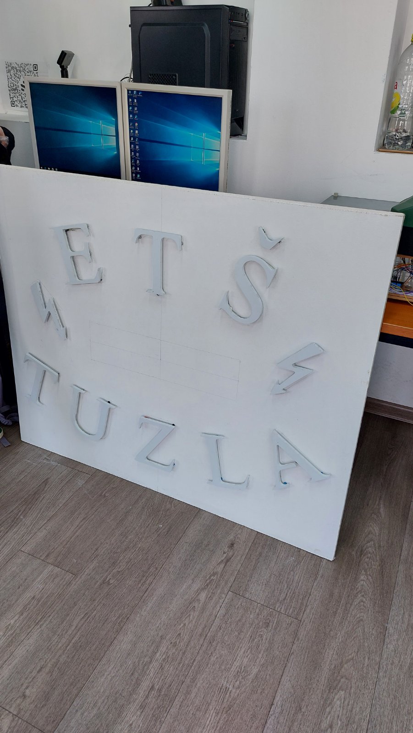
docs/slike/gotovo.jpg
