alma-mesic/school-bell-system/docs/slike/image (1).png

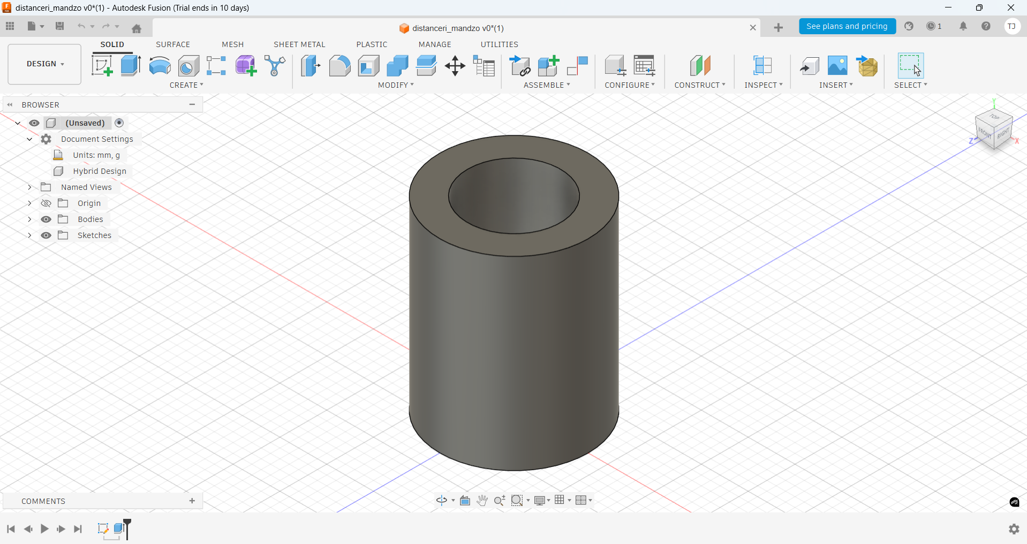
docs/slike/image (1).png
