alma-mesic/school-bell-system/docs/slike/image (3).png

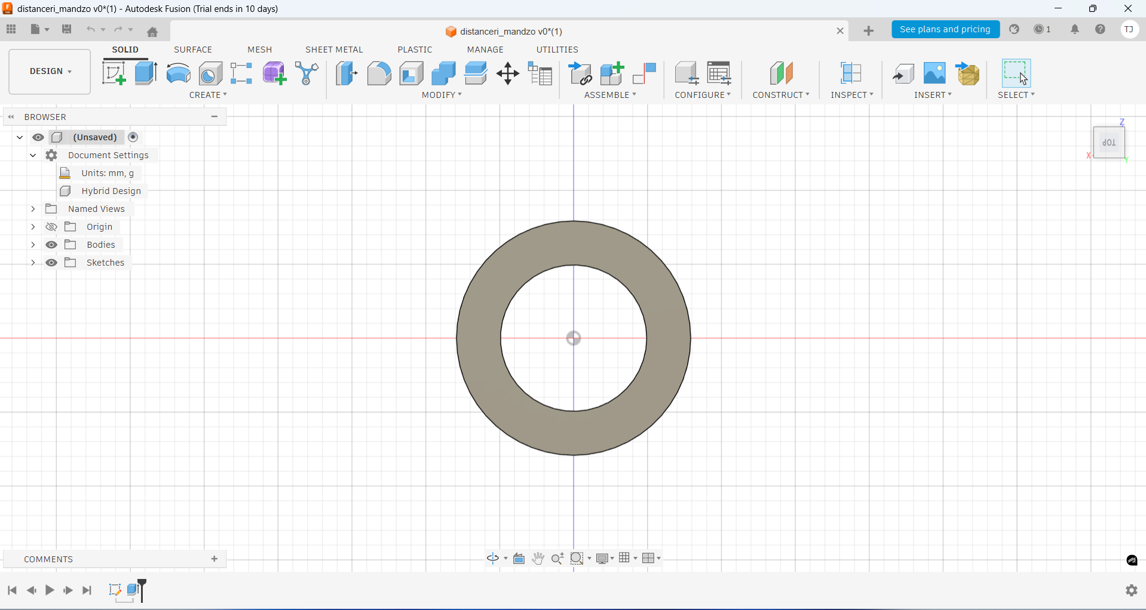
docs/slike/image (3).png
