alma-mesic/school-bell-system/docs/slike/image (4).png

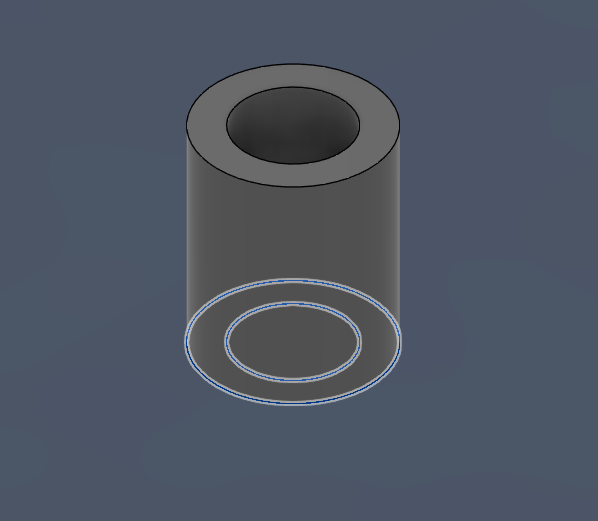
docs/slike/image (4).png
