alma-mesic/school-bell-system/docs/slike/image.png

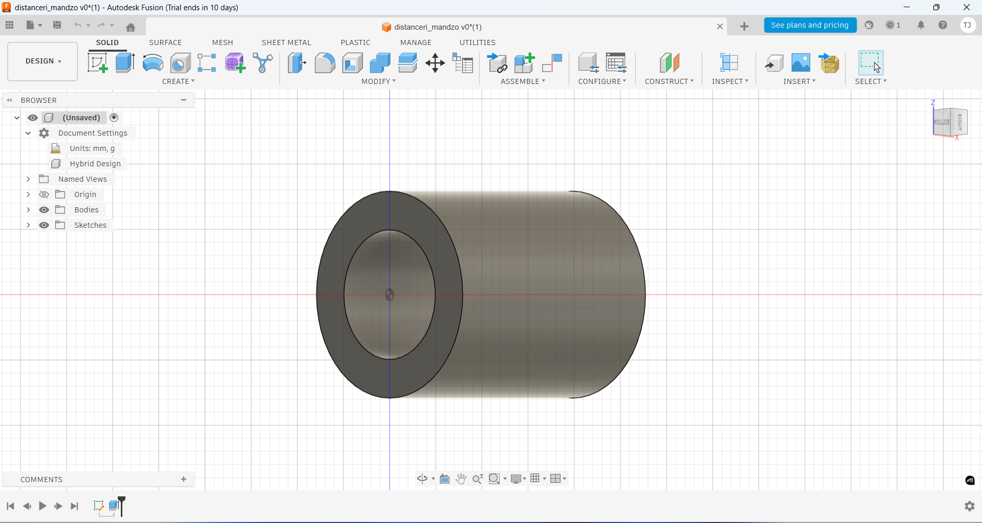
docs/slike/image.png
