alma-mesic/school-bell-system/docs/slike/izrada.jpg

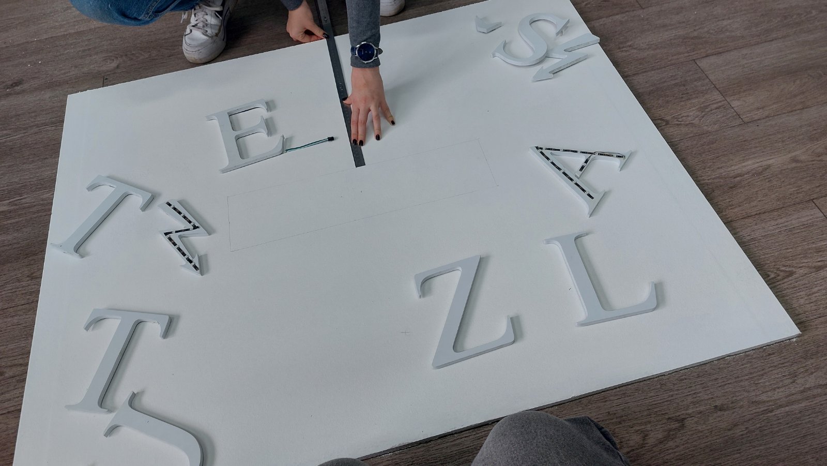
docs/slike/izrada.jpg
