alma-mesic/school-bell-system/docs/slike/konektori.jpg

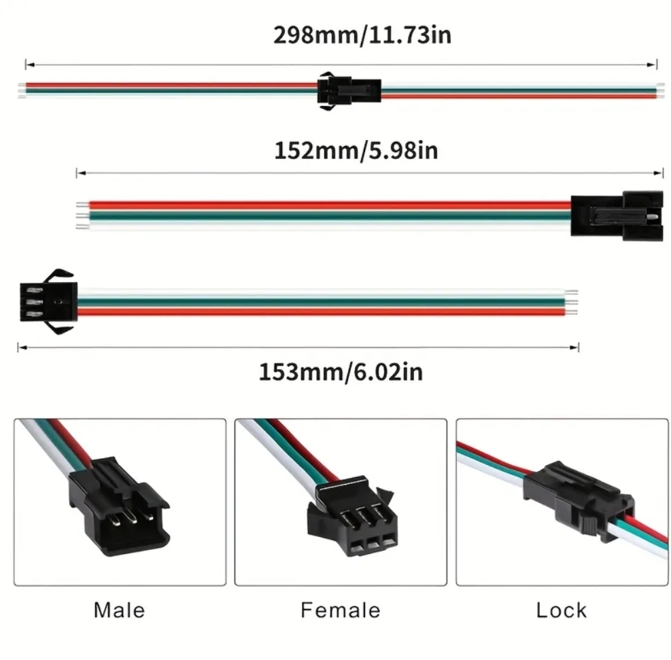
docs/slike/konektori.jpg
