alma-mesic/school-bell-system/docs/slike/ledtraka.jpg

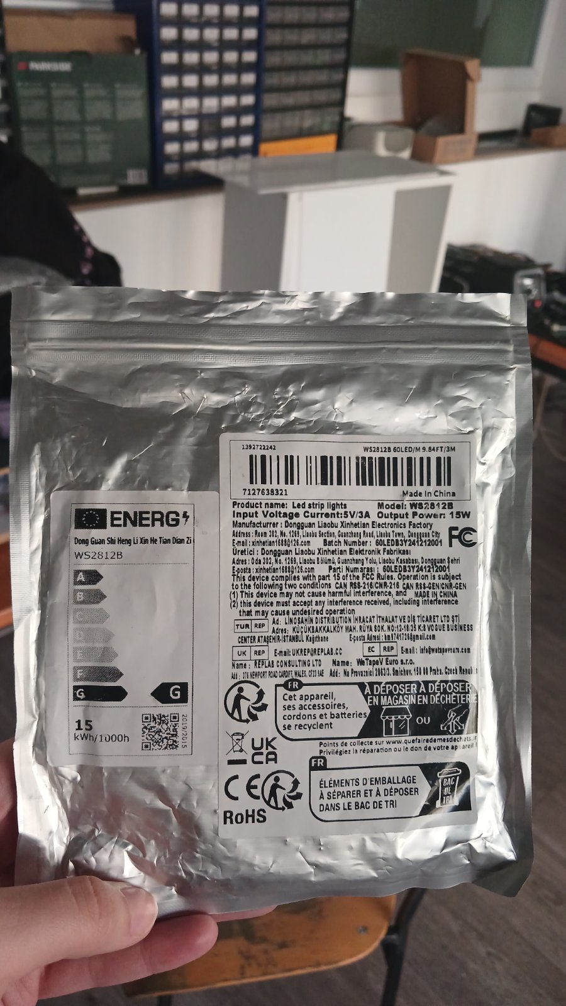
docs/slike/ledtraka.jpg
