alma-mesic/school-bell-system/docs/slike/pozadina.jpg

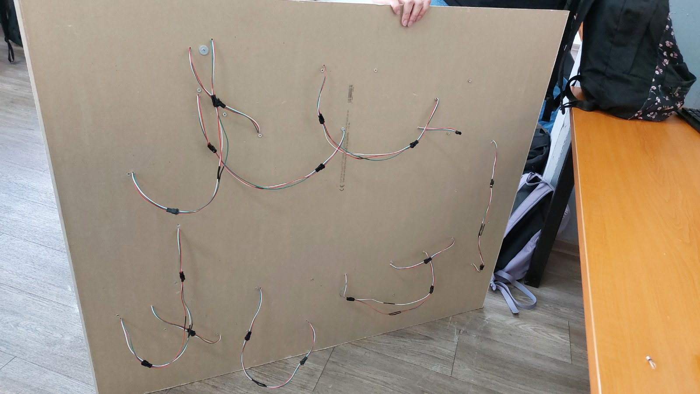
docs/slike/pozadina.jpg
