alma-mesic/school-bell-system/docs/slike/rigips.png

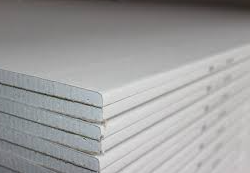
docs/slike/rigips.png
