alma-mesic/school-bell-system/docs/slike/skica.jpg

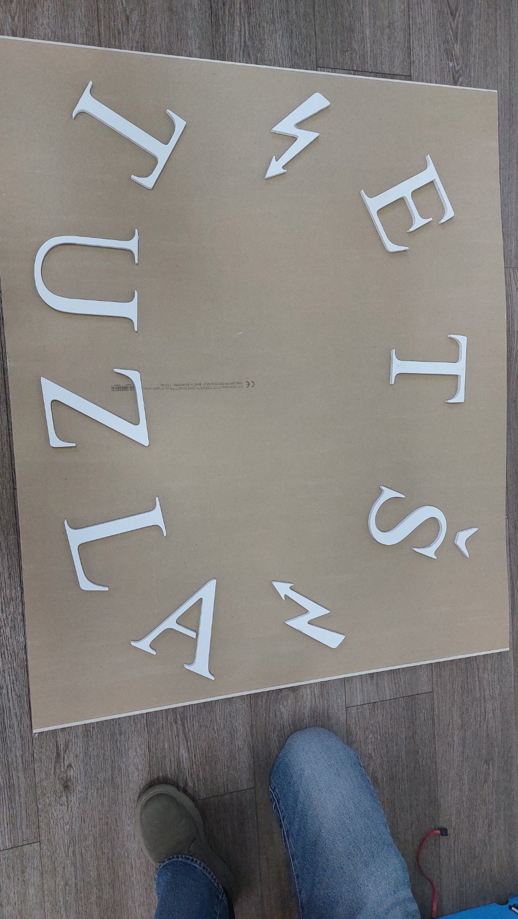
docs/slike/skica.jpg
