alma-mesic/school-bell-system/docs/slike/slika1.png

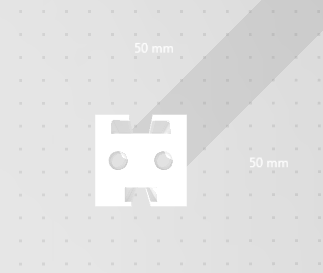
docs/slike/slika1.png
