alma-mesic/school-bell-system/docs/slike/slika2.png

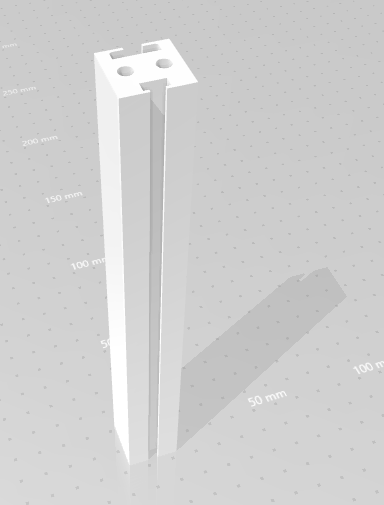
docs/slike/slika2.png
