alma-mesic/school-bell-system/docs/slike/slika3.png

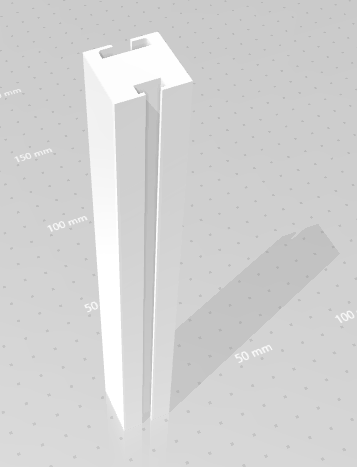
docs/slike/slika3.png
