alma-mesic/school-bell-system/docs/slike/slika_og.png

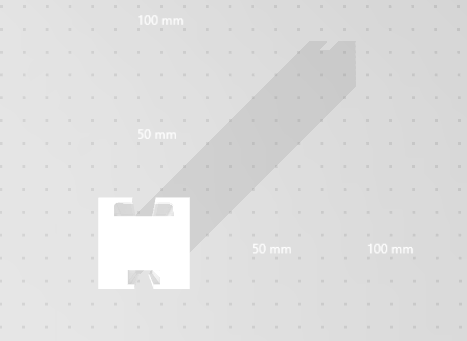
docs/slike/slika_og.png
