alma-mesic/school-bell-system/docs/slike/slova.jpg

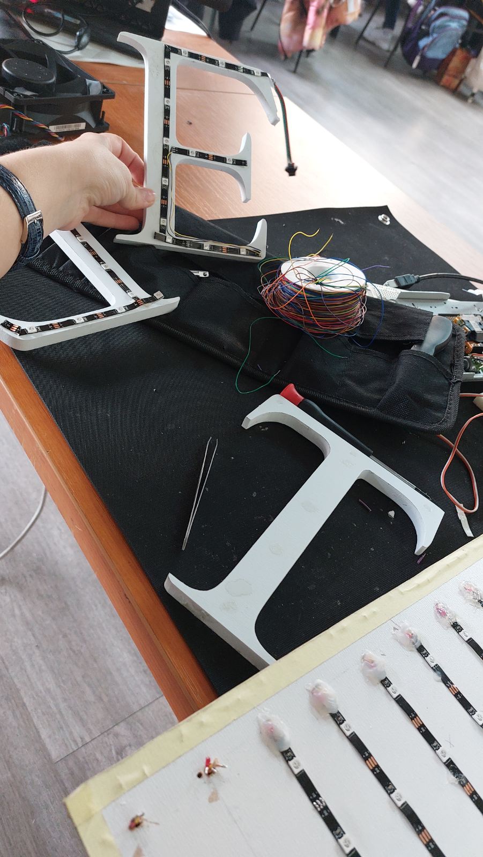
docs/slike/slova.jpg
