alma-mesic/school-bell-system/firmware/trece/trece/data/slike/eco-paint.png

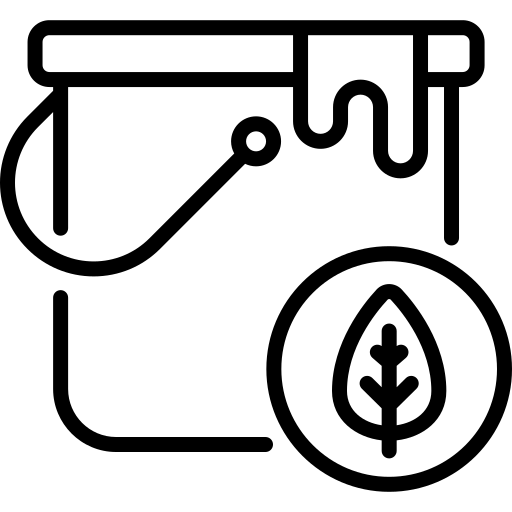
firmware/trece/trece/data/slike/eco-paint.png
