alma-mesic/school-bell-system/firmware/trece/trece/data/slike/kartice/2.png

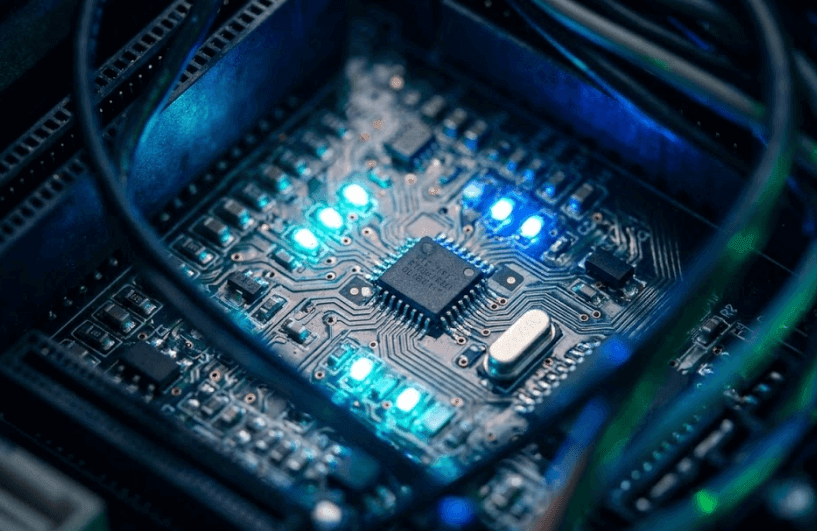
firmware/trece/trece/data/slike/kartice/2.png
