alma-mesic/school-bell-system/firmware/trece/trece/data/slike/kartice/3.png

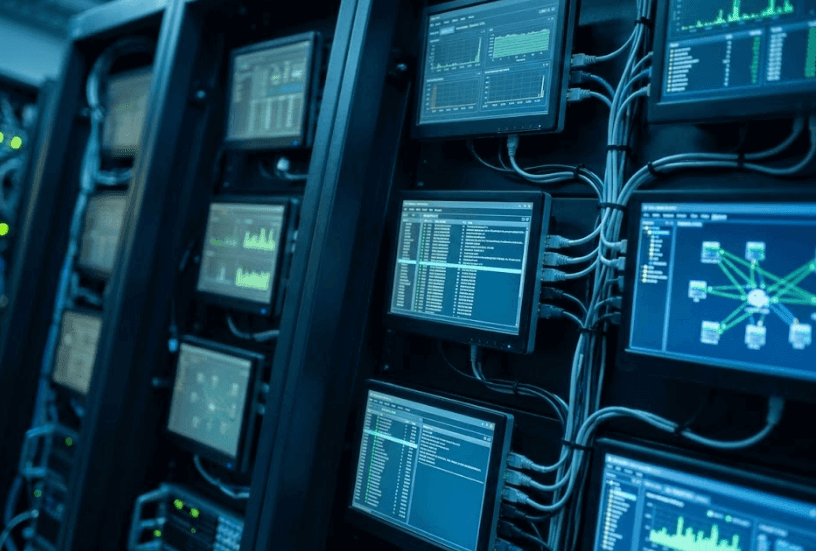
firmware/trece/trece/data/slike/kartice/3.png
