alma-mesic/school-bell-system/firmware/trece/trece/data/slike/kartice/4.png

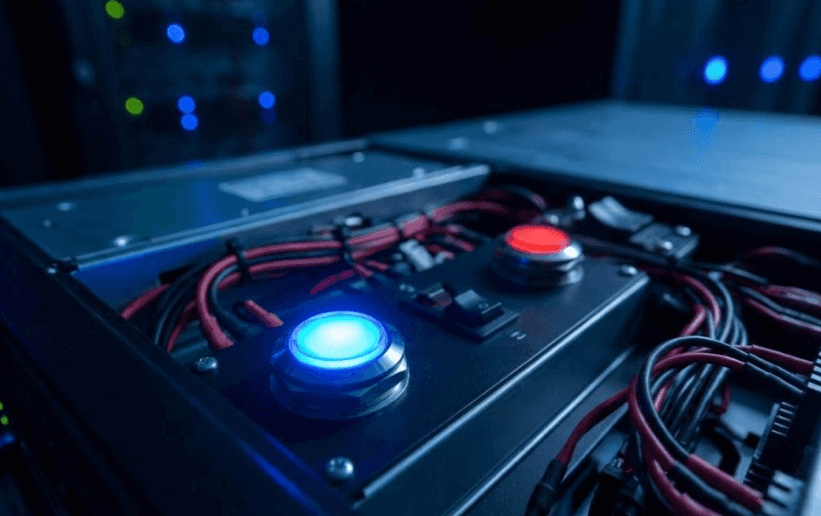
firmware/trece/trece/data/slike/kartice/4.png
