alma-mesic/school-bell-system/firmware/trece/trece/data/slike/kartice/5.png

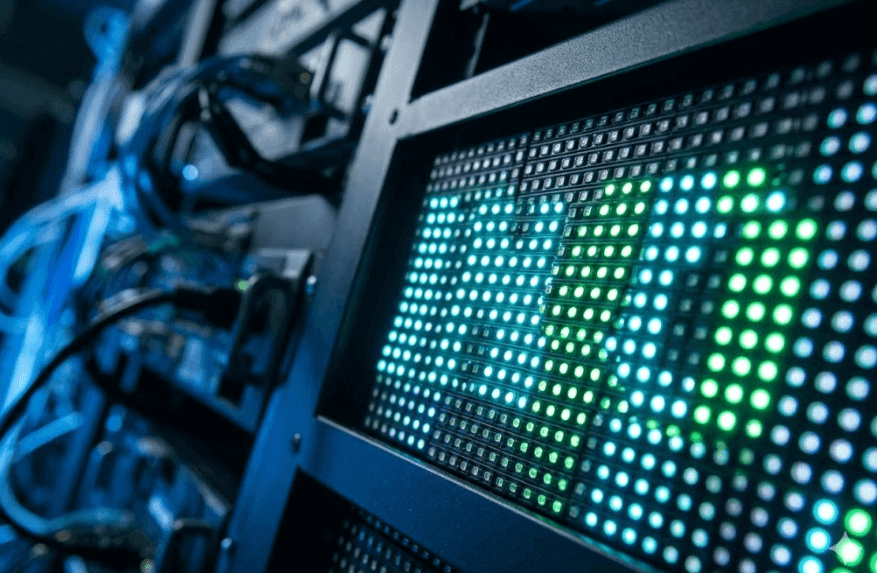
firmware/trece/trece/data/slike/kartice/5.png
