alma-mesic/school-bell-system/firmware/grb/grb.ino

#include <ESP32-HUB75-MatrixPanel-I2S-DMA.h>
#include <WiFi.h>
#include "time.h"

// ================= PANEL =================
#define PANEL_RES_X 64
#define PANEL_RES_Y 32
#define PANEL_CHAIN 2

MatrixPanel_I2S_DMA *display;
HUB75_I2S_CFG mxconfig(PANEL_RES_X, PANEL_RES_Y, PANEL_CHAIN);

// ================= WIFI ==================
const char* ssid = "59588d";
const char* password = "273370344";

// ================= TIME ==================
const char* ntpServer = "pool.ntp.org";
const long gmtOffset_sec = 3600;
const int daylightOffset_sec = 3600;

// ================= STATUS =================
String statusText = "NEMA CASA";

// ================= LOGO =================
// 'ets_grb', 32x32px
const uint16_t epd_bitmap_ets_grb [] PROGMEM = {
	0x0000, 0x0000, 0x0000, 0x0000, 0x0000, 0x0000, 0x0000, 0x0000, 0x0000, 0x0000, 0x0000, 0x0000, 0x0000, 0x0000, 0x0000, 0x0000, 
	0x0000, 0x0000, 0x0000, 0x0000, 0x0000, 0x0000, 0x0000, 0x0000, 0x0000, 0x0000, 0x0000, 0x0000, 0x0000, 0x0000, 0x0000, 0x0000, 
	0x0000, 0x0000, 0x0000, 0x0000, 0x0000, 0x0000, 0x0000, 0x0000, 0x0000, 0x0000, 0x0000, 0x0000, 0x0000, 0x0000, 0x0000, 0x0000, 
	0x0000, 0x0000, 0x0000, 0x0000, 0x0000, 0x0000, 0x0000, 0x0000, 0x0000, 0x0000, 0x0000, 0x0000, 0x0000, 0x0000, 0x0000, 0x0000, 
	0x0000, 0x0000, 0x0000, 0x0000, 0x0000, 0x0000, 0x0000, 0x532a, 0x2a85, 0x2a45, 0x3206, 0x39e7, 0x4228, 0x5b6b, 0x742d, 0x5c2b, 
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
	0x0000, 0x0000, 0x0000, 0x0000, 0x0000, 0x01a0, 0x0c40, 0x0ce0, 0x0ce0, 0x0ce0, 0x0ce0, 0xadb2, 0xef1b, 0xacb0, 0x6bec, 0x844f, 
	0x2be4, 0x13c1, 0x0c20, 0x0c60, 0x0ca0, 0x0cc0, 0x0cc0, 0x0cc0, 0x0cc0, 0x03c0, 0x0160, 0x0000, 0x0000, 0x0000, 0x0000, 0x0000, 
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
// ... (ostatak tvog niza ostaje potpuno isti)
};

// ================= PIN CONFIG =================
void configuration() {

  mxconfig.gpio.r1 = 25;
  mxconfig.gpio.g1 = 26;
  mxconfig.gpio.b1 = 27;

  mxconfig.gpio.r2 = 14;
  mxconfig.gpio.g2 = 12;
  mxconfig.gpio.b2 = 13;

  mxconfig.gpio.a = 23;
  mxconfig.gpio.b = 19;
  mxconfig.gpio.c = 5;
  mxconfig.gpio.d = 17;

  mxconfig.gpio.clk = 16;
  mxconfig.gpio.lat = 4;
  mxconfig.gpio.oe = 15;
}

// ================= WIFI =================
void connectWiFi() {

  WiFi.begin(ssid, password);

  while (WiFi.status() != WL_CONNECTED) {
    delay(500);
  }
}

// ================= TIME =================
String getTimeString() {

  struct tm t;

  if (!getLocalTime(&t))
    return "00:00";

  char buf[6];
  strftime(buf, 6, "%H:%M", &t);

  return String(buf);
}

// ================= DRAW SCREEN =================
void drawScreen() {

  display->clearScreen();

  // GRB (32x32)
  display->drawRGBBitmap(0, 0, epd_bitmap_ets_grb, 32, 32);

  // TIME
  display->setTextSize(2);
  display->setTextColor(display->color565(255,255,255));
  display->setCursor(38,4);
  display->print(getTimeString());

  // STATUS
  display->setTextSize(1);
  display->setTextColor(display->color565(255,0,0));
  display->setCursor(38,24);
  display->print(statusText);
}

// ================= SETUP =================
void setup() {

  configuration();

  display = new MatrixPanel_I2S_DMA(mxconfig);
  display->begin();
  display->setBrightness8(180);
  display->setTextWrap(false);

  connectWiFi();

  configTime(gmtOffset_sec, daylightOffset_sec, ntpServer);

  struct tm timeinfo;
  while(!getLocalTime(&timeinfo)){
    delay(500);
  }
}

// ================= LOOP =================
void loop() {

  drawScreen();

  delay(1000);
}
