alma-mesic/school-bell-system/firmware/test_1.0/test_1.0.ino

#include <ESP32-HUB75-MatrixPanel-I2S-DMA.h>
#include <Adafruit_GFX.h>
#include "time.h"
#include <WiFi.h>

#define PANEL_RES_X 32
#define PANEL_RES_Y 16
#define PANEL_CHAIN 1

MatrixPanel_I2S_DMA *display;
HUB75_I2S_CFG mxconfig(PANEL_RES_X, PANEL_RES_Y, PANEL_CHAIN);

bool startup = true;
unsigned long startTime;

String text = "sedmi cas u toku";
int x = 32;
int16_t text_width; // Za precizan scroll

// WiFi i NTP
const char* ssid = "59588d";
const char* password = "273370344";
const char* ntpServer = "pool.ntp.org";
const long  gmtOffset_sec = 3600;
const int   daylightOffset_sec = 3600;

void connectWiFi() {
  WiFi.begin(ssid, password);
  Serial.print("Povezivanje na WiFi");
  while (WiFi.status() != WL_CONNECTED) {
    delay(500);
    Serial.print(".");
  }
  Serial.println(" Povezano!");
}

String getTimeString() {
  struct tm timeinfo;
  if (!getLocalTime(&timeinfo)) {
    return "00:00";
  }
  char buffer[6];
  strftime(buffer, 6, "%H:%M", &timeinfo);
  return String(buffer);
}

void setup() {
  Serial.begin(115200);

  // Konfiguracija pinova
  mxconfig.gpio.r1 = 25; mxconfig.gpio.g1 = 27; mxconfig.gpio.b1 = 26;
  mxconfig.gpio.r2 = 14; mxconfig.gpio.g2 = 13; mxconfig.gpio.b2 = 12;
  mxconfig.gpio.a = 23; mxconfig.gpio.b = 19; mxconfig.gpio.c = 5;
  mxconfig.gpio.clk = 16; mxconfig.gpio.lat = 4; mxconfig.gpio.oe = 15;

  display = new MatrixPanel_I2S_DMA(mxconfig);
  display->begin();
  display->setBrightness8(120);
  display->clearScreen();
  
  // OVO JE KLJUČNO: Onemogućava prelamanje teksta u novi red
  display->setTextWrap(false);

  startTime = millis();

  // Wi-Fi + NTP
  connectWiFi();
  configTime(gmtOffset_sec, daylightOffset_sec, ntpServer);

  // Čekaj dok NTP ne bude spreman
  struct tm timeinfo;
  while(!getLocalTime(&timeinfo)) {
    delay(500);
    Serial.println("Čekam NTP...");
  }

  // Izračunaj širinu teksta (6 piksela po znaku za standardni font)
  text_width = text.length() * 6;
}

void loop() {
  // ----- STARTUP ETS 10s -----
  if (startup) {
    display->fillScreen(0);
    display->setTextSize(1);
    display->setTextColor(display->color565(255,0,0));
    display->setCursor(6,4);
    display->print("ETS");

    if (millis() - startTime > 10000) {
      startup = false;
      x = 32; 
    }
    delay(100);
    return;
  }

  // ----- GLAVNI PRIKAZ -----
  display->fillScreen(0); // fillScreen je brži od clearScreen

  // 1. Vrijeme (Gornji dio panela, y=0)
  display->setTextSize(1);
  display->setTextColor(display->color565(0,255,255));
  display->setCursor(1, 0); 
  display->print(getTimeString());

  // 2. Scroll obavještenje (Donji dio panela, y=8)
  display->setTextColor(display->color565(255,255,0));
  display->setCursor(x, 8);
  display->print(text);

  // Pomak scrolla
  x--;
  
  // Ako je cijeli tekst izašao s lijeve strane (x je negativna širina teksta)
  if (x < -text_width) {
    x = 32; // Vrati na desnu ivicu
  }

  delay(100); // Brzina scrollanja (manje = brže)
}
