alma-mesic/school-bell-system/(commit log)

2026-01-13 Arduino time and scroll test
2026-01-15 Apply proper .gitignore for VS + ESP32
2026-01-17 All bugs fixed - skeleton
    [pokusaj2.ino]
2026-01-28 LED output update
2026-02-18 led matrix 32x128 layout upadte and .ino fixed
    [pokusaj2.ino]
2026-03-07 grb fixed and documentation 40%
    [grb.ino]
2026-03-11 wireless communication achieved
2026-03-13 something does not work
    [pokusaj2.ino, pokusaj4.ino, pokusaj_finalni.ino]
2026-03-14 test bell fixed - now on 100%
    [trece.ino]
2026-03-15 led mods added
2026-03-15 fixed burger-menu and LED settings
2026-03-30 LED & bell docs
2026-04-02 docs: leds, connections
2026-04-05 JSON insert added
2026-04-08 led bar done
2026-04-08 led traka docs
